nguyentrongtin1702/Robot-Scara-project-new/README.md

# Robot-Scara-project-new
this is the robot's project that i used to use when i were studing in university
in this project, this has all of things that you need to finish
And all of this file here, you should use it for referencing and developing your idea about robotic project
# IN THIS FILE
1. Solidwork robot
2. firmware robot
3. USER INTERFACE using python
4. ...
I hope that it is useful for you all
