nguyentrongtin1702/Robot-Scara-project-new/DO AN ROBOT - SCARA_bản cuối.pdf

i

BỘ GIÁO DỤC & ĐÀO TẠO

TRƯỜNG ĐẠI HỌC SƯ PHẠM KỸ THUẬT TP. HỒ CHÍ MINH

KHOA ĐIỆN – ĐIỆN TỬ

-----------------⸙∆⸙-----------------

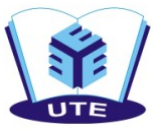
[picture p2: figure]

## ĐỒ ÁN KỸ THUẬT ROBOT

### THIẾT KẾ VÀ ĐIỀU KHIỂN MÔ HÌNH CÁNH TAY ROBOT

### SCARA 3 BẬC TỰ DO VỚI BỘ ĐIỀU KHIỂN PID

GVHD: Th.S Nguyễn Trần Minh Nguyệt

SVTH: Nguyễn Trọng Tín

MSSV: 21151174

SVTH: Nguyễn Tài Tuệ

MSSV: 21151490

Tp. Hồ Chí Minh tháng 06 năm 2025

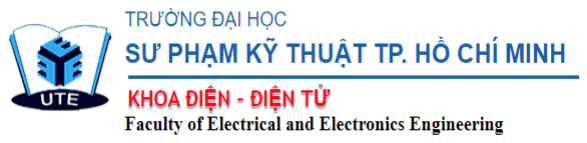
[picture p3: figure]

CỘNG HÒA XÃ HỘI CHỦ NGHĨA VIỆT NAM

Độc lập - Tự Do - Hạnh phúc ------------------
Tp. Hồ Chí Minh, tháng 06 năm 2025

PHIẾU NHẬN XÉT CỦA GIÁO VIÊN HƯỚNG DẪN

Họ và tên: Nguyễn Trọng Tín | MSSV: 21151174
Nguyễn Tài Tuệ | MSSV: 21151490

Ngành: Công nghệ Kỹ thuật Điều khiển và Tự động hóa

Tên đề tài: THIẾT KẾ VÀ ĐIỀU KHIỂN MÔ HÌNH CÁNH TAY ROBOT

SCARA 3 BẬC TỰ DO VỚI BỘ ĐIỀU KHIỂN PID

Giảng viên hướng dẫn: Th.s Nguyễn Trần Minh Nguyệt

NHẬN XÉT:

1. Về nội dung đề tài & khối lượng thực hiện:
2. Ưu điểm:
3. Khuyết điểm:
4. Điểm: | (Bằng chữ: | )
| Tp. Hồ Chí Minh, ngày…. tháng 06 năm 2025
| Giảng viên hướng dẫn
| (Ký & ghi rõ họ tên)

i

## LỜI CẢM ƠN

Chúng em chân thành cảm ơn, quý thầy cô trong khoa Điện – Điện tử trường

Đại học Sư Phạm Kỹ Thuật TP.HCM nói chung và quý thầy cô bộ môn Điều khiển

tự động nói riêng, đã trang bị kiến thức và giúp đỡ chúng em, giải quyết những khó

khăn trong suốt quá trình tìm hiểu và nghiên cứu đề tài.

Đặc biệt chúng em xin chân thành cảm ơn giảng viên hướng dẫn là Cô

Nguyễn Trần Minh Nguyệt đã tận tình hướng dẫn, truyền đạt kiến thức, kinh

nghiệm cho nhóm trong suốt quá trình vừa qua.

Xin chúc quý thầy cô nhiều sức khoẻ, thành công trong công việc, cuộc

sống và tiếp tục đào tạo các sinh viên giỏi góp phần đóng góp cho nhà trường,

đất nước.

Chúng em xin chân thành cảm ơn.

ii

## MỤC LỤC

CHƯƠNG 3: THIẾT KẾ MÔ HÌNH ROBOT TRÊN PHẦN MỀM

iii

CHƯƠNG 4: TÍNH TOÁN ĐỘNG HỌC, ĐỘNG LỰC HỌC, VẼ KHÔNG

GIAN LÀM VIỆC, QUY HOẠCH QUỸ ĐẠO VÀ XÂY DỰNG BỘ ĐIỀU

iv

### 6.5.2 Giao diện GUI điều khiển robot dựa trên thư viện Tkinter của Python:

v

## DANH SÁCH HÌNH ẢNH

Hình 4.5: Cấu trúc chương trình bộ điều khiển PID cho Robot SCARA trên MATLAB

Hình 4.8: Đáp ứng ngõ ra vị trí góc (độ) của 2 khâu robot tại setpoint 45 độ và 60 độ

vi

vii

## DANH SÁCH BẢNG

Bảng 4.7: Code của khối hàm MATLAB Function mô tả động lực học Robot Scara

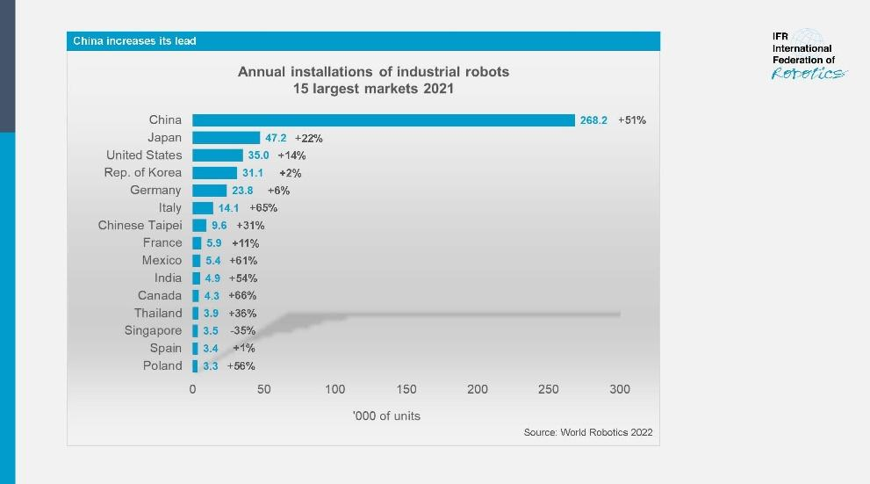
[picture p4: figure]

BỘ MÔN ĐIỀU KHIỂN TỰ ĐỘNG

CHƯƠNG 1

8

## CHƯƠNG 1: TỔNG QUAN VỀ ĐỀ TÀI

### 1.1 Đặt vấn đề:

Ngày nay, với những ưu điểm như sự năng suất, tính hiệu quả và khả thi,

cánh tay robot ngày càng khẳng định được tầm quan trọng của mình trong lĩnh vực

công nghiệp thông qua biểu đồ mô tả số lượng lắp đặt cánh tay máy như hình 1.1.

Hình 1.1: Thống kê số lượng robot được lắp đặt

Theo thống kê IFR (Hiệp hội Robot công nghiệp thế giới), năm 2022, Châu

Á là thị trường lớn nhất về robot công nghiệp được triển khai trên thế giới được lắp

đặt tại đây. Có thể thấy được việc sử dụng cánh tay máy trong công nghiệp đang dần

trở nên phổ biến và vô cùng quan trọng trong hệ thống tự động hóa công nghiệp.

Chẳng hạn như công nghệ thực phẩm, vật liệu xây dụng, luyện kim, chế tạo cơ khí

và một vài lĩnh vực khác. Trong chiến lực phát triển công nghiệp Việt Nam đến năm

2025, tầm nhìn 2035, chính phủ đã đặt ra mục tiêu giá trị sản phẩm công nghiệp cao

và sản phẩm ứng dụng công nghệ cao sau năm 2025 đạt trên 50%. Để làm được điều

này, Việt Nam cần tập trung phát huy nghiên cứu phát triển, làm chủ công nghệ về

robot – lĩnh vực trung tâm của cuộc cách mạng công nghệ lớn.

Bởi vì những lợi ích mà robot mang lại như sự mạnh mẽ, chính xác, tính ổn

định, liên tục… mà robot đã dần thay thế con người và khẳng định vị thế của mình

khi được sử dụng rộng rãi trong nhiều lĩnh vực trong công nghiệp đặc biệt là đối với

các ứng dụng đòi hỏi sự chính xác và tốc độ cao như lắp ráp các chi tiết cơ khí máy

gia công gỗ, vật liệu, đóng gói, hoặc hợp tác với con người để làm việc.

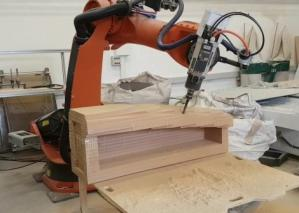
[picture p5: figure]
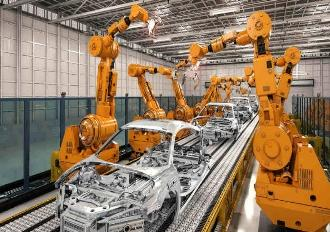
[picture p6: figure]

BỘ MÔN ĐIỀU KHIỂN TỰ ĐỘNG

CHƯƠNG 1

9

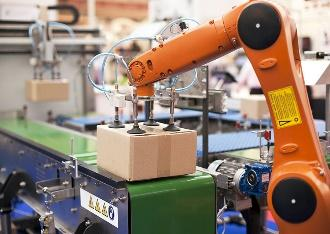
[picture p7: figure]

Hình 1.2: Các ứng dụng của robot

Tại Việt Nam: Nghiên cứu phát triển robot đã có những bước tiến đáng kể

trong 25 năm vừa qua. Nhiều đơn vị trên toàn quốc thực hiện các nghiên cứu cơ bản

và nghiên cứu ứng dụng về robot như Trung tâm Tự động hoá, Đại học Bách Khoa

Hà Nội, Viện Điện tử, Tin học, Tự động hoá thuộc Bộ Công nghệp, Đại học Bách

khoa TP.HCM, Viện Khoa học và Công nghệ quân sự, Học viện Kỹ thuật Quân sự,

Viện Cơ học, Viện Công nghệ thông tin thuộc Viện KHCNVN. Bên cạnh đó còn phải kể đến Công ty Cổ phần Robot TOSY, doanh nghiệp thiết kế và chế tạo robot Việt

Nam có nhiều sản phẩm ấn tượng trên trường quốc tế.

Trên thế giới: Các giải thuật điều khiển nâng cao được chú tâm nghiên cứu mạnh

mẽ như bộ điều khiển PID, điều khiển trượt, điều khiển mờ, điều khiển thích nghi...

đã được triển khai để giải quyết vấn đề robot khi có sự tồn tại của các thông số không

chắc chắn. Ngoài ra, các bộ điều khiển trở kháng, điều khiển kiểm soát lỗi, điều khiển

lực và điều khiển tối ưu đã được nghiên cứu phát triển và áp dụng vào cho cánh tay

máy để cải thiện độ tin cậy, tuổi thọ và độ an toàn khi các cánh tay máy hoạt động

cùng với nhau hay hoạt động song song cùng với con người. Từ những kết quả nghiên

cứu trên, ta có thể thấy các vấn đề liên quan tới robot đã và đang thu hút được rất

nhiều sự quan tâm của rất nhiều nhà nghiên cứu từ các trường đại học, viện nghiên

cứu và các công ty công nghệ ở trên thế giới.

Còn ở Việt Nam robot nói chung và robot công nghiệp thông minh nói riêng đang được sử dụng tại Việt Nam phần lớn là được nhập khẩu về từ các nước phát triển,

robot được chế tạo tại Việt Nam còn rất ít và hầu hết là đang sử dụng công nghệ cũ

của thế giới, chưa có đủ khả năng làm chủ công nghệ để thiết kế theo từng yêu cầu

cụ thể, cũng như chưa phát triển công nghệ phù hợp. Có rất ít công ty sản xuất và

phân phối sản phẩm robot ở trong nước. Nếu có thì hầu hết sản phẩm thuộc phân loại

BỘ MÔN ĐIỀU KHIỂN TỰ ĐỘNG

CHƯƠNG 1

10

robot công nghiệp truyền thống, hạn chế về tính thông minh, bậc tự do, kỹ năng động

lực học nâng cao.

### 1.2 Mục tiêu đề tài:

Mục tiêu của đề tài là thiết kế mô hình robot scara 3 bậc tự do, trong đó em muốn

đạt được các mục tiêu như sau:

❖ Trên mô phỏng:

- Tính toán động học thuận, nghịch, động lực học, quy hoạch quỹ đạo và vẽ

không gian làm việc robot trên MATLAB.
- Thiết kế mô hình robot sử dụng phần mềm SolidWorks.
- Thiết kế bộ điều khiển PID cho robot dựa trên các phương trình động lực học

robot.

❖ Trên thực nghiệm:
- Thiết kế mô hình thực robot.
- Kiểm chứng và chạy động học trên mô hình thực để gắp thả vật 5 điểm trên

bàn cờ.
- Xây dựng giao diện người dùng để quan sát và điều khiển robot.
- Thiết kế bộ điều khiển PID cho mô hình thực.

### 1.3 Giới hạn đề tài:

Trong khuôn khổ đề tài này, chỉ xem xét và nghiên cứu:

- Kiểm chứng động học thuận và động học nghịch trên mô hình thực.
- Kiểm chứng động lực học robot trên mô phỏng MATLAB
- Quy hoạch quỹ đạo cho robot trên mô phỏng MATLAB
- Chưa quan tâm đến động lực học robot trên mô hình thực.
- Chưa quy hoạch quỹ đạo trên mô hình thực.

### 1.4 Phương pháp nghiên cứu:

Đề tài sẽ áp dụng các phương pháp nghiên cứu sau:

Phân tích dữ liệu: Sử dụng công cụ MATLAB quan sát và thu thập dữ liệu từ các đồ thị đáp ứng và đưa ra một số đánh giá về kết quả của hệ thống dựa vào đồ thị

đáp ứng.

BỘ MÔN ĐIỀU KHIỂN TỰ ĐỘNG

CHƯƠNG 1

11

Phân tích mô phỏng: Dựa vào công cụ trên MATLAB Simulink để mô phỏng

động học, quy hoạch quỹ đạo, mô phỏng đáp ứng của bộ điều PID.

Phân tích thí nghiệm: Thực hiện trên mô hình thực nghiệm, dựa vào kết quả

thu được so sánh với kết quả trên mô hình mô phỏng và lý thuyết.

Tiêu chí đánh giá hệ thống: Đánh giá hệ thống qua kết quả trả về sai số bám

của robot so với tín hiệu đặt. So sánh chất lượng điều khiển dựa trên dữ liệu đã thu

thập trước đó.
Cải tiến thuật toán: Dựa trên kết quả đánh giá và phân tích, cải tiến cho thuật

toán điều khiển có thế là thay đổi các thông số bộ điều khiển.

Đánh giá kết quả: Đánh giá kết quả của các cải tiến thuật toán và so sánh với

hiệu suất của phiên bản ban đầu.

### 1.5 Nội dung đề tài:

Đề tài gồm có 7 chương:

Chương 1: Tổng quan về đề tài.

Chương 2: Cơ sở lý thuyết.

Chương 3: Thiết kế mô hình robot trên phần mềm SolidWorks.

Chương 4: Tính toán động học, động lực học, vẽ không gian làm việc, quy hoạch quỹ đạo và xây dựng bộ điều khiển cho robot.

Chương 5: Thi công mô hình thực tế.

Chương 6: Thiết kế chương trình điều khiển.

Chương 7: Kết luận và hướng phát triển.

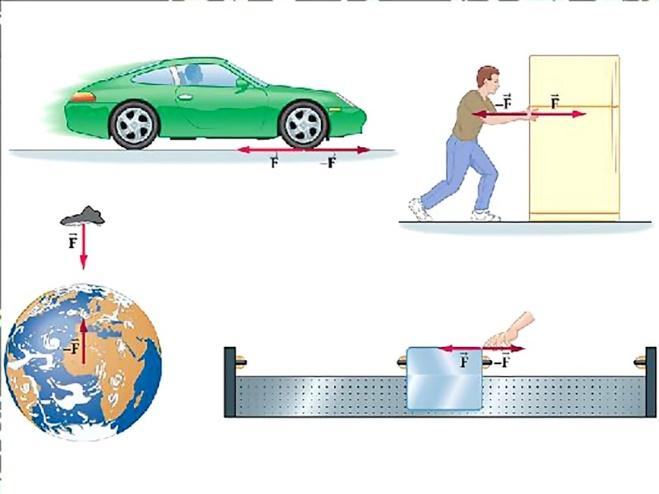
[picture p8: figure]

BỘ MÔN ĐIỀU KHIỂN TỰ ĐỘNG

CHƯƠNG 2

12

## CHƯƠNG 2: CƠ SỞ LÝ THUYẾT

### 2.1 Cơ sở lý thuyết về Lực, Torque và phương pháp cánh tay đòn:

Lực là bất kì ảnh hưởng nào làm cho một vật thể chịu sự thay đổi về hình dạng hay

làm ảnh hưởng đến chuyển động của nó. Nói cách khác lực là nguyên nhân làm cho

một vật có khối lượng thay đổi vận tốc hay làm biến dạng vật thể.

Một số ví dụ đơn giản về lực: Khi bạn đá quả bóng, bạn tác động một lực lên nó.

Khi bạn ngồi xuống, bạn chịu tác động của lực hấp dẫn trái đất. Mặt trăng chịu lực

hấp dẫn Trái Đất nên xoay quanh Trái Đất với một quỹ đạo nhất định, ... Tóm lại lực

nó có thể làm thay đổi hình dạng hoặc cấu trúc của một vật thể tùy vào độ lớn và

phương, chiều của lực.

Hình 2.1: Một số ví dụ đơn giản về lực

Trong khi lực tác động lên một vật sẽ tạo cho vật một chuyển động thẳng, tịnh tiến,

thì Torque được định nghĩa là khuynh hướng của lực làm xoay một vật quanh một trục cố định. Nói nôm na Torque cũng tương tự như lực nhưng sẽ tạo chuyển động

xoay cho vật.
Một ví dụ đơn giản: Ta muốn xoay một con ốc nhưng nếu sử dụng tay vặn thông

thường sẽ khó có thể mở con ốc ra, do đó ta sẽ dùng cờ lê để vặn ốc ra như ta tác

động một lực vào cờ lê và cờ lê có độ dài là d, d này được coi là cánh tay đòn, giúp cho việc vặn ốc trở nên dễ dàng hơn. Ta có công thức tính Torque xoay quanh trục

của con ốc là:

τ = Fd

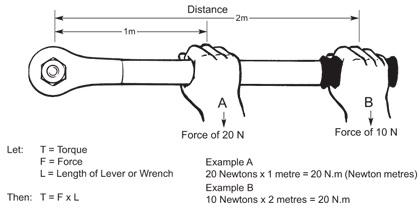
[picture p9: figure]

BỘ MÔN ĐIỀU KHIỂN TỰ ĐỘNG

CHƯƠNG 2

13

Theo như công thức độ lớn của τ sẽ tỉ lệ thuận với lực F tác động và độ dài cánh tay đòn d. Với một lực cố đinh, cánh tay đòn càng dài thì τ sẽ càng lớn.

Hình 2.2: Ví dụ về Torque

Trong trường hợp sử dụng động cơ RC Servo, lực tác động lên thanh robot chủ yếu là trọng lực và được tính bằng công thức:

F = mg

Trong đó: m là khối lượng của vật (kg) và g là hằng số gia tốc trọng trường g =

9.81m/s²

. Từ công thức, ta có mối quan hệ giữa Torque và cánh tay đòn là tỉ lệ thuận.

### 2.2 Động cơ DC có Encoder:

### 2.2.1 Khái niệm động cơ encoder:

Động cơ Encoder (motor encoder, tiếng Anh là Rotary Encoder) là tên của 1 loại

động cơ có phần con quay được tích hợp trong 1 hệ thống tự động nhằm mục đích

tạo tín hiệu xung trong hoạt động điều khiển động cơ hoặc các máy móc, thiết bị vận

hành trong quá trình sản xuất.

Mục đích chủ yếu của các dòng encoder chính là thực hiện mã hóa số vòng quay

nhằm mục đích tạo tín hiệu xung có dạng vuông ở trong quá trình điều khiển động

cơ.
Dựa trên sơ đồ tín hiệu có dạng nhị phân thì tất cả các dòng encoder đều có thể hỗ

trợ hoán đổi được các vị trí góc hoặc các vị trí thẳng căn cứ theo yêu cầu người sử

dụng có mong muốn dịch chuyển đến vị trí điều khiển như thế nào.

### 2.2.2 Các loại encoder:

❖ Encoder tuyệt đối:

- Encoder tuyệt đối (adsolute encoder): tức là tín hiệu ta nhận được từ Encoder

cho biết chính xác vị trí của Encoder mà không phải xử lý thêm gì cả.

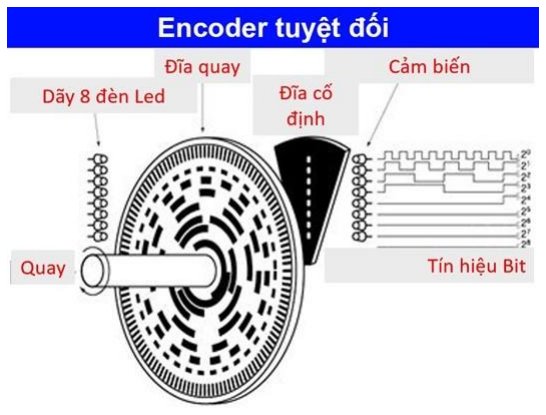
[picture p10: figure]
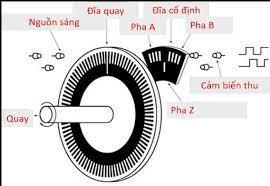
[picture p11: figure]

BỘ MÔN ĐIỀU KHIỂN TỰ ĐỘNG

CHƯƠNG 2

14

- Sử dụng đĩa theo mã nhị phân hoặc mã Gray.
- Có kết cấu gồm: bộ phát ánh sáng (LED), đĩa mã hóa (có chứa dãi băng mang

tín hiệu), một bộ thu ánh sáng nhạy với ánh sáng phát ra.
- Đĩa mã hóa ở Encoder được chế tạo từ vật liệu trong suốt, người ta đã chia mặt

đĩa thành các góc đều nhau cùng các đường tròn đồng tâm.

Hình 2.3: Encoder tuyệt đối

❖ Encoder tương đối:

- Encoder tương đối (incremental encoder): loại thiết bị này sẽ phát ra tín hiệu

tăng dần hoặc theo chu kỳ, có các đặc điểm như sau:

- Đĩa mã hóa bao gồm một dãy băng tạo xung, thường được chia thành nhiều lỗ

bằng nhau và được cách đều nhau.

- Chất liệu có thể là trong suốt để giúp ánh sáng chiếu qua.
- Là Encoder chỉ có 1,2 hoặc tối đa 3 vòng lỗ, và thường có thêm một lỗ định

vị.

Hình 2.4: Encoder tương đối

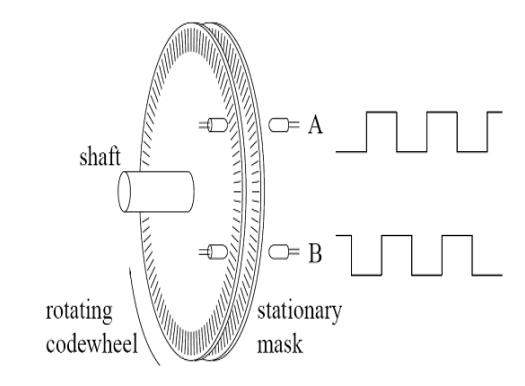
[picture p12: figure]

BỘ MÔN ĐIỀU KHIỂN TỰ ĐỘNG

CHƯƠNG 2

15

### 2.2.3 Nguyên lý làm việc của động cơ có encoder:

Encoder hoạt động tuân theo nguyên lý đó là khi ta cung cấp nguồn cho nó và khi

tất cả các trục quay đều hoạt động. Đồng thời, động cơ còn tạo cho đĩa tròn được

xoay vòng khi bạn đã xoay kéo theo chiếc đèn led sáng.

Ở trên đĩa tròn xoay còn có 1 cái lỗ và các lỗ này cũng được xen kẽ nhau. Dựa vào

đó, hệ thống xử lý vi sẽ đếm tất cả các lượt quay bằng cách đèn xuyên qua lỗ, hoặc

có thể không xuyên qua bằng 1 con bắt tích hợp ở trong đó truyền báo về.

Cũng chính vì vậy, các xung vuông của động cơ được tạo ra và bạn có thể đếm

được thông qua độ cắt của ánh sáng từ chiếc đèn led thông qua các lỗ hổng trên.

Hình 2.5: Encoder

### 2.3 Lý thuyết bộ điều khiển PID:

### 2.3.1 Khái niệm:

Bộ điều khiển vi tích phân tỉ lệ (bộ điều khiển PID) là một kỹ thuật điều khiển

quá trình với sự kết hợp của 3 bộ điều khiển: tỉ lệ, tích phân và vi phân, có khả năng

điều chỉnh sai số thấp nhất có thể, tăng tốc độ đáp ứng, giảm độ vọt lố, hạn chế dao

động.
Bộ điều khiển PID sẽ tính toán giá trị "sai số" là hiệu số giữa giá trị đo thông số

biến đổi và giá trị đặt mong muốn. Bộ điều khiển sẽ thực hiện giảm tối đa sai số bằng

cách điều chỉnh giá trị điều khiển đầu vào.

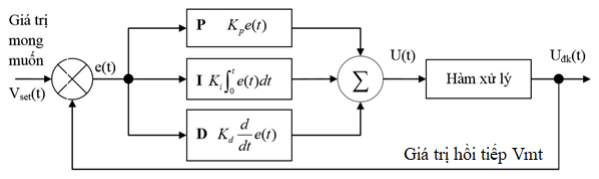
[picture p13: figure]
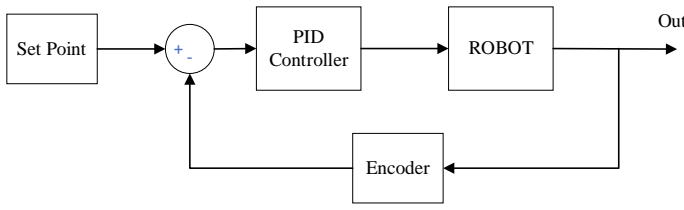
[picture p14: figure]
PID; Controller; ROBOT; Encoder; Set Point

BỘ MÔN ĐIỀU KHIỂN TỰ ĐỘNG

CHƯƠNG 2

16

Hình 2.6: Cấu trúc bộ điều khiển PID cho hệ vòng kín

Phương trình PID tổng quát:

U(t) = Kpe(t) + Ki ∫ e(t)dt + Kd

d
dt

t
0

e(t)

Trong đó:
− Vset là giá trị đặt (Setpoint) mong muốn.

− Vmt là giá trị Sensor phản hồi về vi điều khiển.

− e = Vset – Vmt là sai số giữa tín hiệu đặt và tín hiệu hồi tiếp.

− U là giá trị PID tính toán được.

− Uđk là giá trị điều khiển hệ thống

− Các giá trị Kp, Ki, Kd là các hằng số tỷ lệ, tích phân và vi phân

### 2.3.2 Thiết kế bộ điều khiển PID cho hệ thống:

Output

Hình 2.7: Cấu trúc bộ điều khiển PID cho hệ thống

Nguyên lý hoạt động: Tín hiệu đặt (Set point) là góc cần quay của robot. Thông

qua bộ điều khiển PID sẽ tính toán các thông số và đưa tín hiệu điều khiển vào robot.

Thông qua tín hiệu đọc về từ encoder, tín hiệu trả về là góc tại thời điểm t. Sai số giữa

tín hiệu đặt và tín hiệu trả về sẽ được tính toán và tiếp tục được đưa qua bộ điều khiển

để hiệu chỉnh tín hiệu điều khiển.

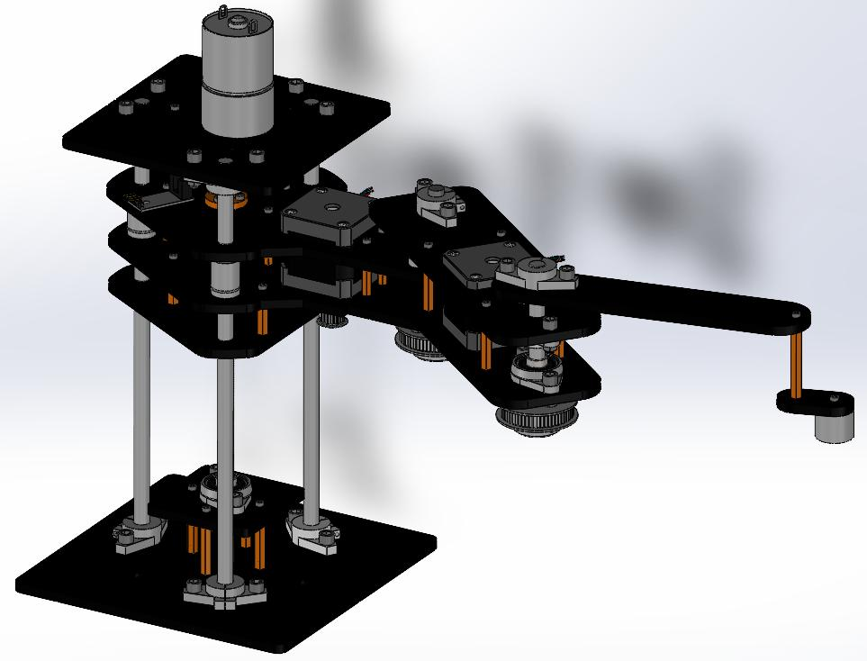
[picture p15: figure]

BỘ MÔN ĐIỀU KHIỂN TỰ ĐỘNG

CHƯƠNG 3

17

## CHƯƠNG 3: THIẾT KẾ MÔ HÌNH ROBOT TRÊN

## PHẦN MỀM SOLIDWORKS

### 3.1 Vẽ mô hình robot trên phần mềm SolidWorks:

Hình 3.1: Tổng quan mô hình Robot Scara đã thiết kế trên SolidWorks

Mô hình cánh tay Robot Scara 3 bậc tự do được hình thành từ 4 khâu chính bao gồm phần đế, khâu 1, khâu 2 và khâu 3. Để thiết kế được mô hình cánh tay Robot

Scara 3 bậc tự do như trên, đầu tiên ta sẽ tiến hành thiết kế lần lượt từng khối riêng

biệt. Sau đó tiến hành lắp ghép các khối lại với nhau ta thu được một mô hình cánh

tay Robot Scara 3 bậc tự do hoàn chỉnh. Các bước thiết kế sẽ được trình bày trong

các phần tiếp theo.

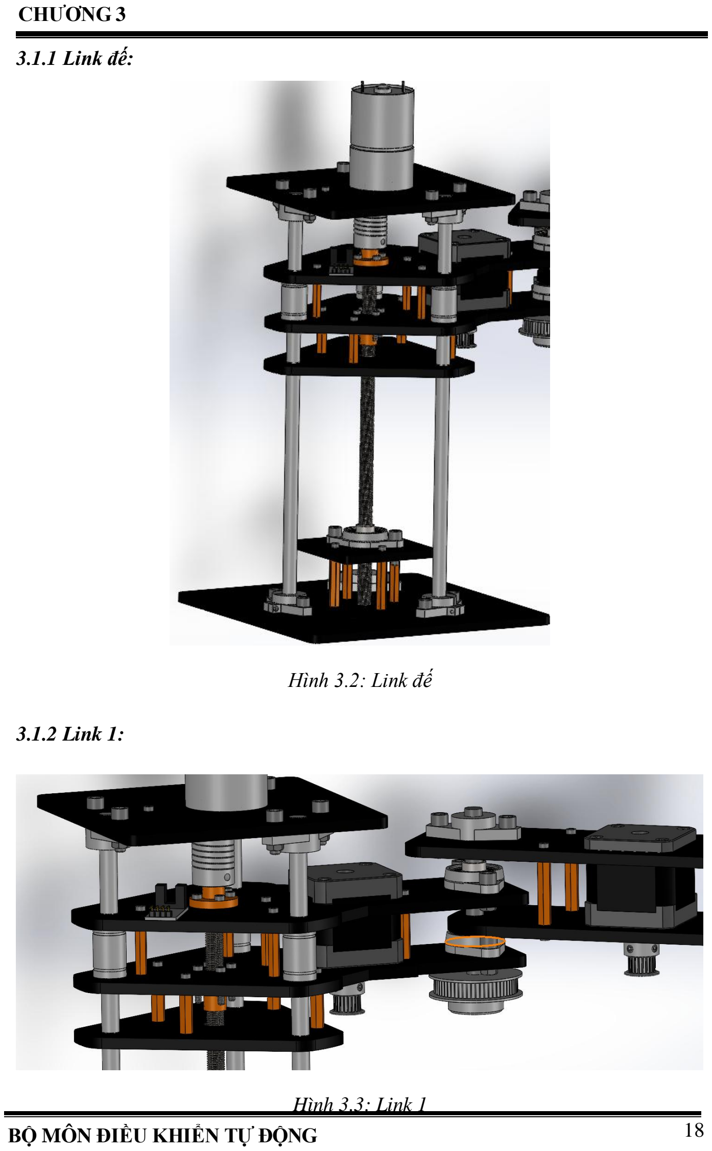
[picture p16: page 20]

BỘ MÔN ĐIỀU KHIỂN TỰ ĐỘNG

CHƯƠNG 3

18

### 3.1.1 Link đế:

Hình 3.2: Link đế

### 3.1.2 Link 1:

Hình 3.3: Link 1

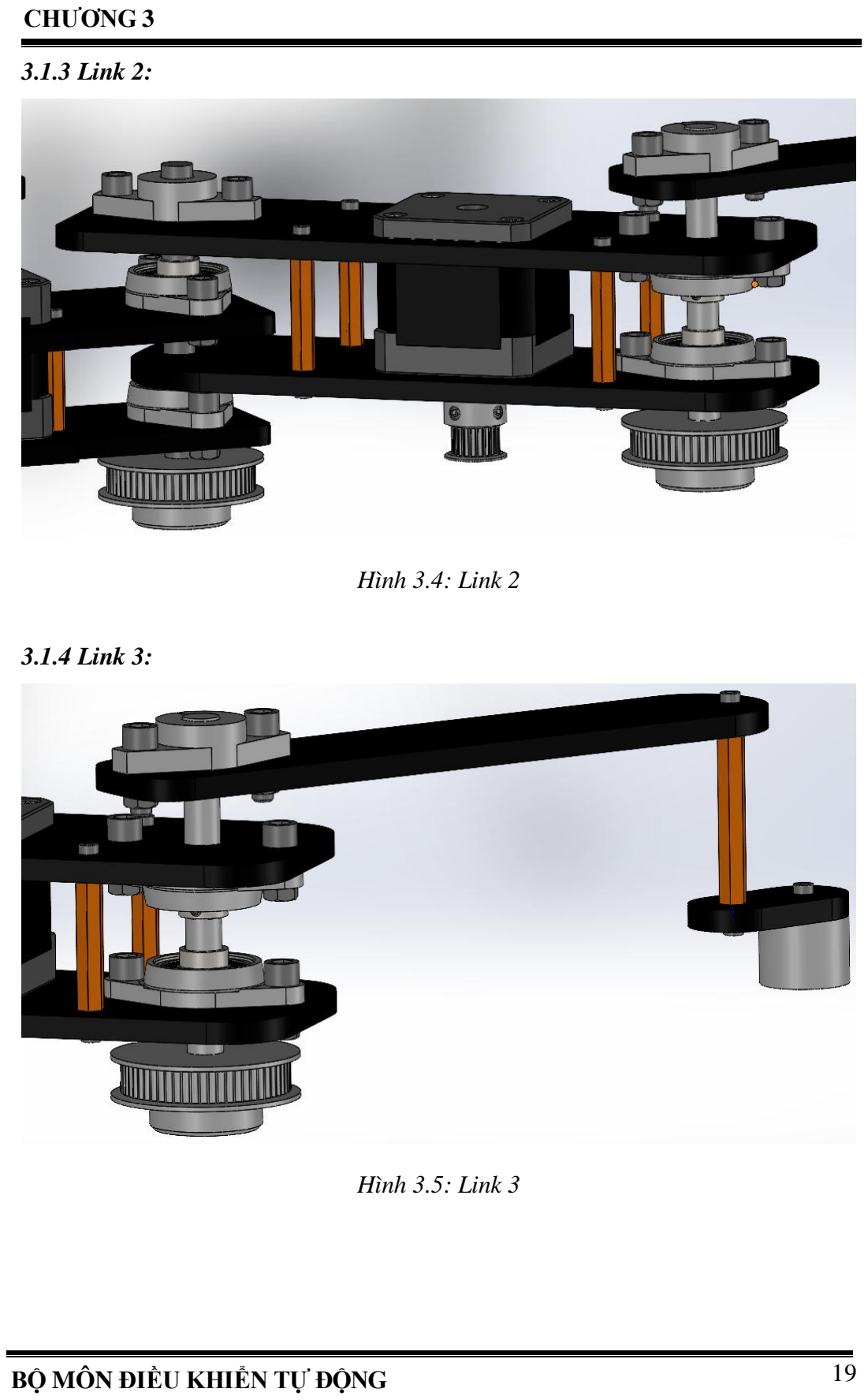
[picture p17: page 21]

BỘ MÔN ĐIỀU KHIỂN TỰ ĐỘNG

CHƯƠNG 3

19

### 3.1.3 Link 2:

Hình 3.4: Link 2

### 3.1.4 Link 3:

Hình 3.5: Link 3

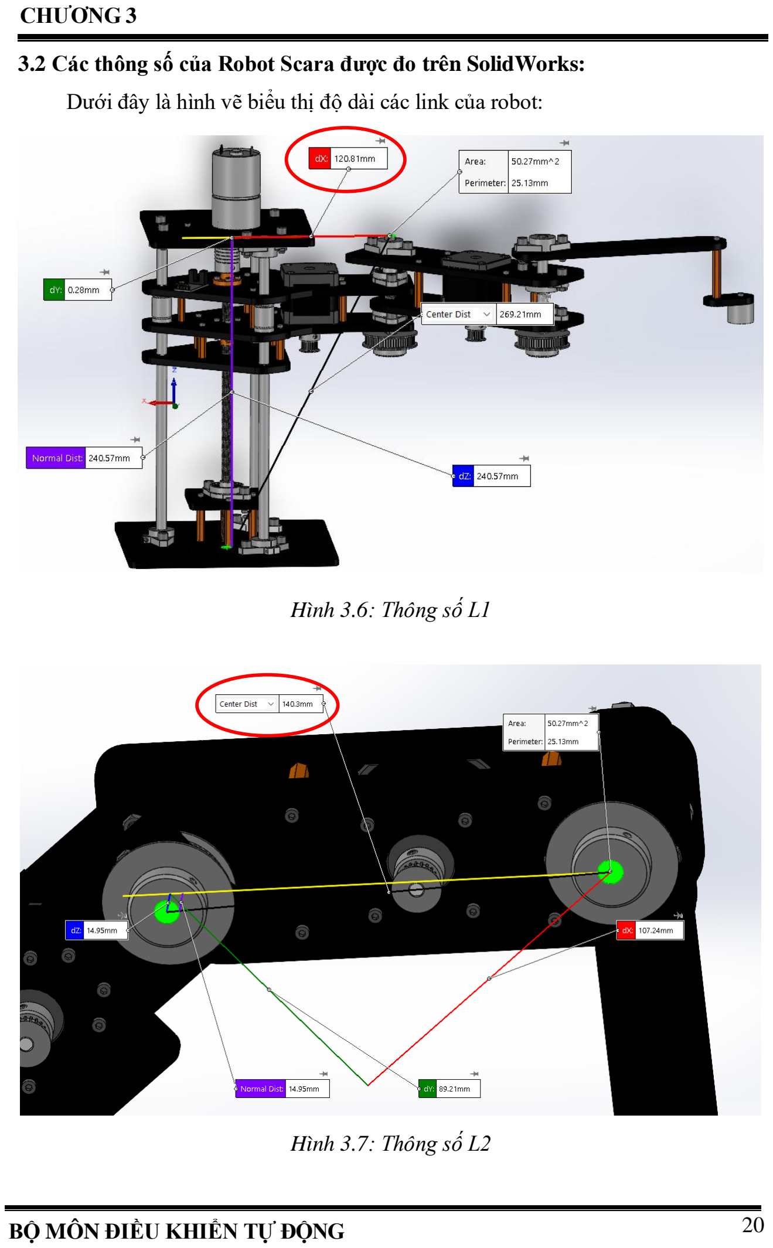
[picture p18: page 22]

BỘ MÔN ĐIỀU KHIỂN TỰ ĐỘNG

CHƯƠNG 3

20

### 3.2 Các thông số của Robot Scara được đo trên SolidWorks:

Dưới đây là hình vẽ biểu thị độ dài các link của robot:

Hình 3.6: Thông số L1

Hình 3.7: Thông số L2

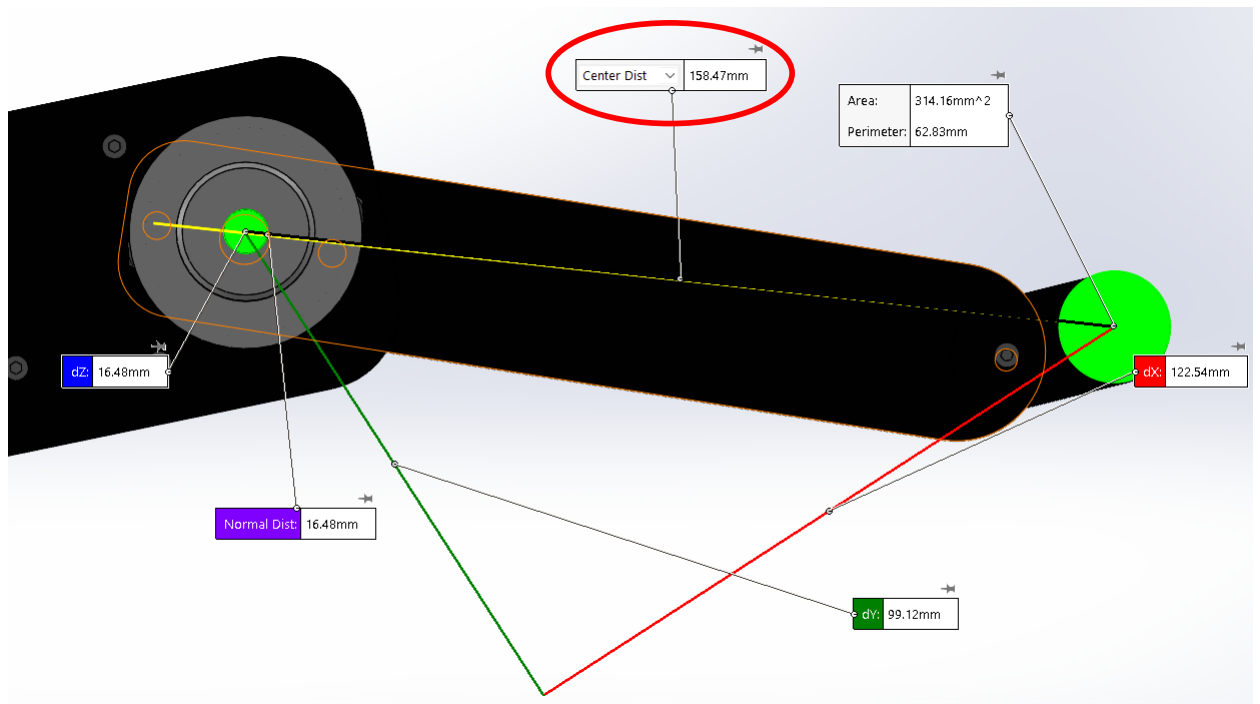
[picture p19: figure]

BỘ MÔN ĐIỀU KHIỂN TỰ ĐỘNG

CHƯƠNG 3

21

Hình 3.8: Thông số L3

Qua đó, ta có bảng thông số Robot Scara như sau:

Thông số | Kích thước (mm)
L1 | 120.81
L2 | 140.3
L3 | 158.47
Bảng 3.1: Các thông số robot

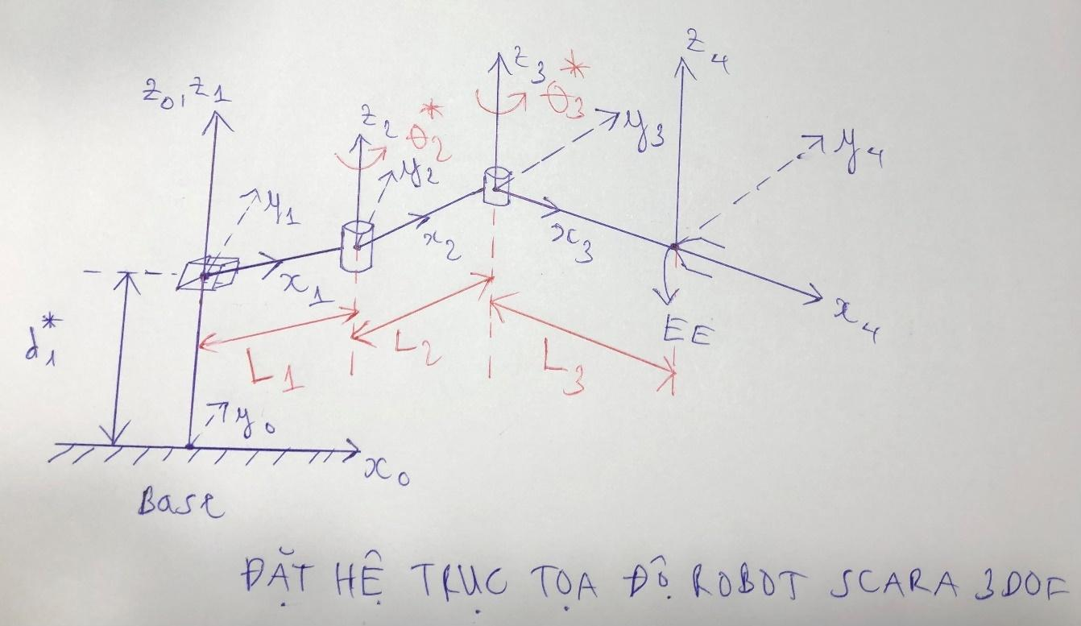
[picture p20: figure]

BỘ MÔN ĐIỀU KHIỂN TỰ ĐỘNG

CHƯƠNG 4

22

## CHƯƠNG 4: TÍNH TOÁN ĐỘNG HỌC, ĐỘNG LỰC

## HỌC, VẼ KHÔNG GIAN LÀM VIỆC, QUY HOẠCH

## QUỸ ĐẠO VÀ XÂY DỰNG BỘ ĐIỀU KHIỂN CHO

## ROBOT SCARA

### 4.1 Đặt hệ trục tọa độ Robot Scara:

Hình 4.1: Đặt hệ trục tọa độ cho robot scara 3 bậc tự do
Cấu trúc Robot Scara 3 bậc tự do gồm phần đế, 1 khớp tịnh tiến và 2 khớp

xoay tương ứng với cấu hình như sau:

- Khớp tịnh tiến được đặt vuông góc với mặt đất
- Khớp xoay thứ 2 và thứ 3 song song nhau và song song với khớp tịnh tiến.
- d1

là khoảng cách từ X0 đến X1 đo dọc theo trục Z1

. Vì là khớp tịnh tiến

nên d1 có thể thay đổi được.

- L1

là khoảng cách từ Z1 đến Z2 đo dọc theo trục X1

- L2

là khoảng cách từ Z2 đến Z3 đo dọc theo trục X2

- L3

là khoảng cách từ Z3 đến Z4 đo dọc theo trục X3

- Các khớp xoay lần lượt là θ2

,θ3 và khớp tịnh tiến là d1

BỘ MÔN ĐIỀU KHIỂN TỰ ĐỘNG

CHƯƠNG 4

23

Hệ trục tọa độ cánh tay robot được đặt như sau:
Hệ tọa độ gốc {0} được đặt ở mặt phẳng đế, trục Z0 được chọn dọc theo hướng

tịnh tiến của khớp thứ 1, trục X0 nằm song song với mặt phẳng đế, trục Y0 được xác

định theo quy tắc bàn tay phải.

Hệ tọa độ {1} được đặt trục X1Y1Z1 cùng phương và hướng với X0Y0Z0 nhưng

tâm của hệ tọa độ {1} được tịnh tiến lên xuống (không cố định) với một đoạn là d1 .

Hệ tọa độ {2} được đặt tại tâm xoay khớp thứ 2, trục Z2 được đặt dọc theo trục

khớp thứ 2, trục X2 nằm dọc theo khâu 2 (dọc theo đường vuông góc chung giữa Z2và

Z3

), trục Y2 được xác định theo nguyên tắc bàn tay phải.

Hệ tọa độ {3} được đặt tại khớp xoay thứ 3, trục Z3 được đặt dọc theo trục

khớp thứ 3, trục X3 nằm dọc theo khâu 3 (dọc theo đường vuông góc chung giữa Z3và

Z4
).
Hệ tọa độ cơ cấu chấp hành cuối {4} được đặt tại điểm cuối robot để có thể dễ

dàng xác định hướng và vị trí của cánh tay máy, các trục X4Y4Z4được đặt cùng

phương và hướng với X3Y3Z3

### 4.2 Lập bảng DH và tính toán động học thuận:

Bước 1: Lập bảng D-H

Từ hình 4.1 ta lập được bảng DH như sau:

i | a − i 1 | αi−1 | d i | θi
1 | 0 | 0 | d 1 | 0
2 | L1 | 0 | 0 | θ2
3 | L2 | 0 | 0 | θ3
4 | L3 | 0 | 0 | 0

Bảng 4.1: Bảng DH
Bước 2: Tìm ma trận chuyển đổi đồng nhất giữa các hệ trục tọa độ

iT

i−1 =
[
cos( θi) | −sin( θi) | 0 | ai−1
sin( θi) cos( αi−1) cos( θi) cos( αi−1) − sin( αi−1) − sin( αi−1)di
sin( θi) sin( αi−1) cos( θi) sin( αi−1) | cos( αi−1) | cos( αi−1)di
0 | 0 | 0 | 1

]

BỘ MÔN ĐIỀU KHIỂN TỰ ĐỘNG

CHƯƠNG 4

24

Ma trận chuyển đổi từ hệ trục tọa độ {1} sang hệ trục tọa độ gốc {0}:

1T

0 | = [
1 0 0 | 0
0 1 0 | 0
0 0 1 d1
0 0 0 1

]

Ma trận chuyển đổi từ hệ trục tọa độ thứ {2} sang hệ trục tọa độ thứ {1}:

2T

1 = [

cos( θ2) − sin( θ2) 0 L1
sin( θ2) | cos( θ2) | 0 0
0 | 0 | 1 0
0 | 0 | 0 1

]

Ma trận chuyển đổi từ hệ trục tọa độ thứ {3} sang hệ trục tọa độ thứ {2}:

3T

2 = [

cos( θ3) − sin( θ3) 0 L2
sin( θ3) | cos( θ3) | 0 | 0
0 | 0 | 1 | 0
0 | 0 | 0 | 1

]

Ma trận chuyển đổi từ hệ trục tọa độ cơ cấu chấp hành cuối {4} sang hệ trục

tọa độ thứ {3}:

4T

3 = [

1 0 0 L3
0 1 0 0
0 0 1 0
0 0 0 1

]

Bước 3: Tìm ma trận chuyển đổi đồng nhất giữa hệ trục tọa độ cơ cấu chấp

hành cuối {4} và hệ trục tọa độ gốc {0}

4T

0 | = 1T
| 0
2T

1
3T

2
4T

3 = [
4R

0
4P

0
0 0 0 1

]

Bước 4: Xác định ma trận hướng và ma trận vị trí từ ma trận chuyển đổi đồng

nhất tìm được từ Bước 3.

Ma trận hướng:

4R

0 | = [
r11 | r12 | r13
r21 | r22 | r23
r31 | r32 | r33

] = [

c23 | −s23 | 0
s23 | c23 | 0
0 | 0 | 1

]

Trong đó si

, ci

, s23 và c23 lần lượt thể hiện cho sin( θi), cos( θi), sin( θ2 +

θ3) và cos( θ2 + θ3), tương ứng với (i = 1,2,3)

BỘ MÔN ĐIỀU KHIỂN TỰ ĐỘNG

CHƯƠNG 4

25

Ma trận vị trí:

4P

0 = [

px
py
pz

]

Trong đó

px = L1 + L3c23 + L2c2

py = L3s23 + L2s2

pz = d1

### 4.3 Tính toán động học nghịch:

Định nghĩa 1: Đặt hàm tính toán lượng giác basis_02, để giải phương trình lượng

giác dạng:
{

a cos( x) − b sin( x) = c
b cos( x) + a sin( x) = d

Từ pt bên trên, ta giải hệ phương trình bậc nhất hai ẩn là cos(x) và sin(x) ta được:

{

sin( x) =

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
cos( x) =

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
Suy ra phương trình chỉ có một nghiệm.

x = atan 2 (sin(x) , cos(x))

Hay

x = atan 2 (ad − bc, ac + bd)

Điều kiện phương trình thỏa mãn
{
2a

2 + 2b

2 − (c

2 + d

2
) ≥ 0
a ≠ 0
- Giải θ3
: Từ ma trận vị trí ta có:
{

px − L1 = L3c23 + L2c2
py = L3s23 + L2s2

BỘ MÔN ĐIỀU KHIỂN TỰ ĐỘNG

CHƯƠNG 4

26

Ta lấy tổng bình phương hai vế của phương trình, suy ra:

(px − L1

)

2 + (py)

2
= (L3c23 + L2c2

)

2 + (L3s23 + L2s2
)

2

Triển khai vế phải của phương trình, rút gọn lại ta được:

(px − L1

)

2 + (py)

2
= L3

2 + L2

2 + 2L2L3c3

Chuyển vế phương trình để rút ra
3

c

c3 =

(px−L1

)

2+(py)

2
−L3

2−L2

2

2L2L3
Đặt {

nx = px − L1
ny = py

Phương trình trở thành

c3 =

nx

2+ny

2−L3

2−L2

2

2L2L3

Suy ra
s3 = ±√1 − (c3
)

2

Ta tìm được nghiệm:
θ3 = atan2(s3

, c3)

- Giải θ2
:
Từ kết quả phương trình bên trên ta suy ra được:
{

nx = L3c23 + L2c2 = c2(L3c3 + L2) − s2(L3s3) ny = L3s23 + L2s2 = s2(L3c3 + L2) + c2(L3s3)

Dùng hàm lượng giác dạng basic_02, ta tìm được nghiệm: θ2 = atan2(A, B)

Với
{
A = ny

(L3c3 + L2

) − nxL3s3
B = nx

(L3c3 + L2

) + nyL3s3

### 4.4 Kiểm chứng động học thuận – nghịch robot:

Để kiểm chứng động học thuận trên Matlab Simulink, ta sử dụng 1 khối

Constant với kích thước ma trận [3x1] để nhập 1 giá trị khoảng cách và 2 giá trị góc

tương ứng cho d1

,θ2

, θ3 của các khớp và 1 khối Display để hiển thị 3 vị trí Px, Py,

BỘ MÔN ĐIỀU KHIỂN TỰ ĐỘNG

CHƯƠNG 4

27

Pz của cơ cấu chấp hành. Chương trình trong khối MATLAB Function ở Bảng 4.2 là

kết quả tính toán động học thuận mà ta đã tìm được ở trên.

function Position = ForwardKinematics(Dis_Ang)
d1 = Dis_Ang(1);
theta2 = Dis_Ang(2);
theta3 = Dis_Ang(3);
%% Thông số robot SCARA
L1 = 120.81; L2 = 140.3; L3 = 158.47;
%% Forward Kinematics
Px = L1 + L3*cosd(theta2 + theta3) + L2*cosd(theta2); Py = L3*sind(theta2 + theta3) + L2*sind(theta2);
Pz = d1;
Position = [Px; Py; Pz];
end
Bảng 4.2: Chương trình MATLAB kiểm chứng động học thuận

Để kiểm chứng động học nghịch trên Matlab Simulink, ta sử dụng 1 khối

Constant với kích thước ma trận [3x1] để nhập 3 giá trị vị trí Px, Py, Pz của cơ cấu

chấp hành và 1 khối Display để hiển thị khoảng cách d1 và 2 góc tương ứng cho θ2 ,θ3

của các khớp. Chương trình trong khối MATLAB Function ở Bảng 4.3 là kết quả tính

toán động học nghịch mà ta đã tìm được ở trên.

function Dis_Ang = InverseKinematics(Position,button)
Px = Position(1);
Py = Position(2);
Pz = Position(3);
%% Thông số robot SCARA
L1 = 120.81; L2 = 140.3; L3 = 158.47; %% Inverse Kinematics
% theta3
nx = Px - L1;
ny = Py;
c3 = (nx^2 + ny^2 - L3^2 - L2^2)/(2*L2*L3); if button == 0
s3 = sqrt(1 - (c3^2));
else
s3 = -sqrt(1 - (c3^2));
end
theta3 = atan2d(s3,c3);
% theta2
A = ny*(L3*cosd(theta3) + L2)- nx*L3*sind(theta3); B = nx*(L3*cosd(theta3) + L2)+ ny*L3*sind(theta3); theta2 = atan2d(A,B);
Dis_Ang = [Pz; theta2; theta3];

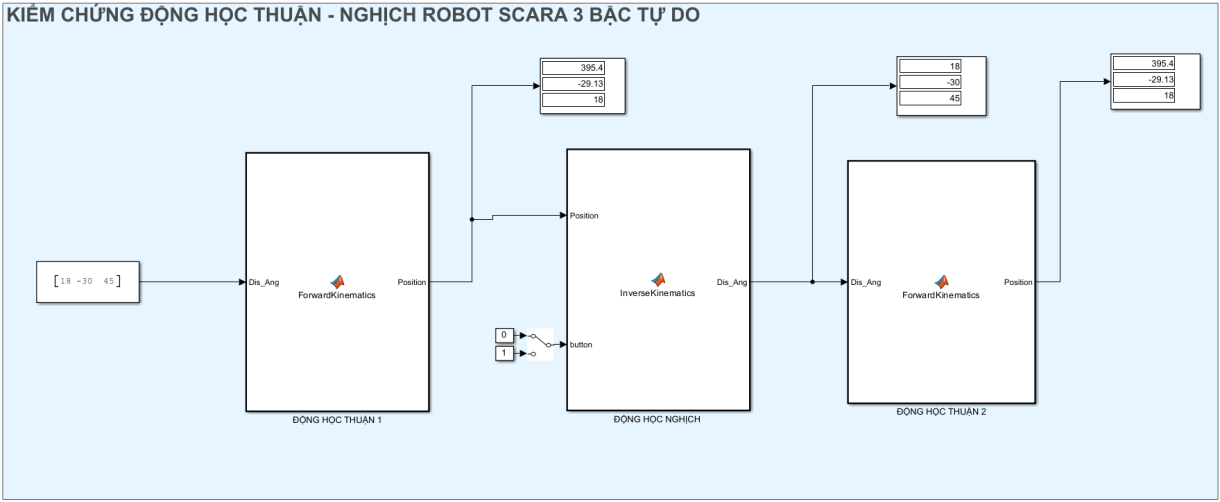
[picture p21: figure]

BỘ MÔN ĐIỀU KHIỂN TỰ ĐỘNG

CHƯƠNG 4

28

end
Bảng 4.3: Chương trình Matlab kiểm chứng động học nghịch

Hình 4.2: Kiểm chứng động học thuận – nghịch trên MATLAB Simulink

### 4.5 Vẽ không gian làm việc của robot:

Với các giới hạn góc d1 ∈ [0; 250]; θ2 ∈ [−

π
2

;

π
2

]; θ3 ∈ [−

π
2

;

π
2

], độ dài các

thanh liên kết là L1 = 120.81, L2 = 140.3, L3 = 158.47, chúng ta sử dụng phần mềm

MATLAB để vẽ được không gian làm việc của Robot.

clc;
close all;
clear all;
%% Thông số robot SCARA
L1 = 120.81; L2 = 140.3; L3 = 158.47; %% Chương trình
m = [];
for d1 = 0:8:250
for the2 = -90:8:90
for the3 = -90:8:90
x = L1 + L3*cosd(the2 + the3) + L2*cosd(the2); y = L3*sind(the2 + the3) + L2*sind(the2);
z = d1;
m(:, end + 1) = [x; y; z];
%m(1:3, end + 1) = [x; y; z];
end
end
end
%% Hiển thị
figure;
grid on;
plot3(m(1,:), m(2,:), m(3,:),'*b', 'MarkerSize', 3);

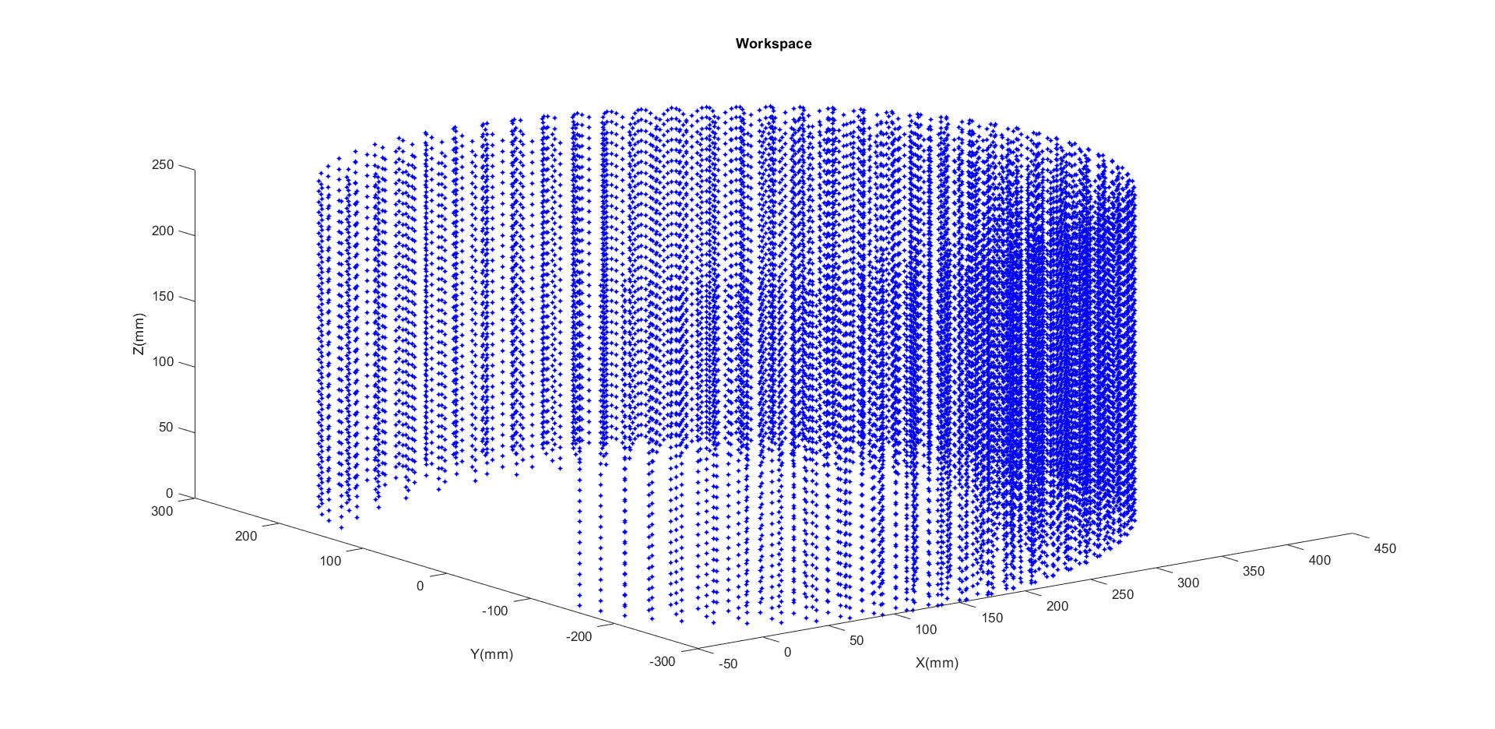
[picture p22: figure]

BỘ MÔN ĐIỀU KHIỂN TỰ ĐỘNG

CHƯƠNG 4

29

title("Workspace");
xlabel("X(mm)");
ylabel("Y(mm)");
zlabel("Z(mm)");

Bảng 4.4: Chương trình MATLAB vẽ không gian làm việc của Robot

Hình 4.3: Không gian làm việc Robot Scara

### 4.6 Tính toán quy hoạch quỹ đạo cho Robot:

Chọn đa thức bậc 3 (Cubic) để quy hoạch quỹ đạo robot.

Yêu cầu 4 điều kiện biên: vị trí và vận tốc.

Bởi vì các biên dạng gia tốc liên tục không giống như các quỹ đạo vận tốc hình

thang nên các quỹ đạo đa thức rất hữu ích để nối các đoạn lại với nhau với vận tốc và

gia tốc bằng không hoặc khác không.

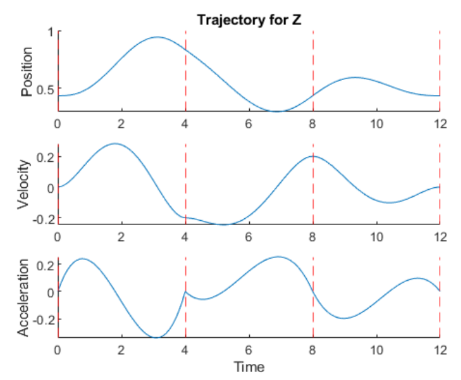
[picture p23: figure]

BỘ MÔN ĐIỀU KHIỂN TỰ ĐỘNG

CHƯƠNG 4

30

Hình 4.4: Quy hoạch quỹ đạo kiểu đa thức

❖ Các điều kiện ràng buộc:

Tại điểm bắt đầu:

t = t0

, q(t0

) = q0
,

d
dt

q(t0) = v0

Tại điểm đích:

t = tf, q(tf) = qf,

d
dt

q(tf) = vf

Phương trình đa thức bậc 3:

q(t) = a0 + a1
t + a2

t

2 + a3
t

3
,

d
dt

q(t) = a1 + 2a2
t + 3a3

t

2

Từ các điều kiện ràng buộc ta có:

q0 = a0 + a1

t0 + a2

t0

2 + a3
t0

3

v0 = a1 + 2a2

t0 + 3a3

t0

2

qf = a0 + a1

tf + a2

tf

2 + a3
tf

3

vf = a1 + 2a2

tf + 3a3

tf

2

Các tham số của đa thức bậc 3 có thể được tính như sau:

{

a0 = q0
a1 = v0

a2 =

3
tf

2

(qf − q0) −

2
tf

v0 −

1
tf

vf

a3 = −

2
tf

3

(qf − q0) +

1
tf

2

(vf + v0)

BỘ MÔN ĐIỀU KHIỂN TỰ ĐỘNG

CHƯƠNG 4

31

### 4.7 Tính toán động lực học Robot:

### 4.7.1 Các thông số vật lý của robot:

Kí hiệu | Mô tả | Thông số
m1 | Khối lượng khớp thứ nhất | 2 kg
m2 | Khối lượng khớp thứ hai | 1.5 kg
m3 | Khối lượng khớp thứ ba | 1 kg
L1 | Chiều dài khớp thứ nhất | 0.12081 m
L2 | Chiều dài khớp thứ hai | 0.1403 m
L3 | Chiều dài khớp thứ ba | 0.15847 m
I2 | Moment quán tính khớp thứ hai | 0.01 kg.m²
I3 | Moment quán tính khớp thứ ba | 0.01 kg.m²
g | Gia tốc trọng trường | -9.81 m/s²
θ2 | Góc quay khớp thứ hai | radian
θ3 | Góc quay khớp thứ ba | radian
b | Hệ số ma sát trượt | 0.1
c | Hệ số ma sát nhớt | 10⁻⁴

Bảng 4.5: Các thông số vật lí của hệ cánh tay Robot Scara

### 4.7.2 Các phương trình mô tả hệ thống:

Giả sử trọng tâm nằm ở vị trí giữa khâu, các thông số moment quán tính, hệ số

ma sát trượt và ma sát nhớt được đề cập ở bảng 4.5. Bỏ qua ngoại lực tác động.

Các biến khớp là θ = [θ2 θ3] T

Vì đế robot được đặt cố định nên:

0ω

0 = [0 0 0]

T
, 0v

0 = [0 0 0]

T

Gia tốc trọng trường ngược với chiều trục Z0 của hệ tọa độ gốc nên:

g

0 = [

0
0
−9.81

]

BỘ MÔN ĐIỀU KHIỂN TỰ ĐỘNG

CHƯƠNG 4

32

Từ các tính toán động học thuận phía trên ta có những ma trận sau:

1R

0 = [

1 0 0
0 1 0
0 0 1

], 1P

0 = [

0
0
d1

], 0R

1 = [

1 0 0
0 1 0
0 0 1

],

c P1

1 = [

L1
2

0 0]

T
, 1P

0 = [0 0 d1
]

T

2R

1 | = [
cθ2 | −sθ2 | 0
sθ2 | cθ2 | 0
0 | 0 | 1

], 2P

1 = [

L1
0
0

], 1R

2 | = [
cθ2 | sθ2 | 0
−sθ2 | cθ2 | 0
0 | 0 | 1

],

c P2

2 = [

L2
2

0 0]

T
, 2P
1 | = [L1 | 0 0]

T

3R

2 | = [
cθ3 | −sθ3 | 0
sθ3 | cθ3 | 0
0 | 0 | 1

], 3P

2 = [

L2
0
0

], 2R

3 | = [
cθ3 | sθ3 | 0
−sθ3 | cθ3 | 0
0 | 0 | 1

],

c P3

3 = [

L3
2

0 0]

T
, 3P
2 | = [L2 | 0 0] T

Xác định vận tốc tuyến tính và vận tốc quay của từng trục:

Tại khâu 1:
- Vị trí trọng tâm của khâu 1 so với trục gốc:
| | c P1
0 | = 1T

0
. c P1

1

- Vì là chuyển động tịnh tiến nên vận tốc góc tại hệ trục tọa độ 1 bằng 0:
| | 1ω
1 | = [

0
0/0]
- Vận tốc dài tại hệ trục tọa độ 1:

1v

1 = 0R

1
( 0v

0 + 0ω

0
. 1P

0
)
- Vận tốc dài tại trọng tâm khâu 1 so với trục gốc:

c v1

0 = 1R

0
( 1v

1 + 1ω

1
. c P1

1
) = 1R

0
∗ 1v

1

Tại khâu 2:
- Vị trí trọng tâm của khâu 2 so với trục gốc:

BỘ MÔN ĐIỀU KHIỂN TỰ ĐỘNG

CHƯƠNG 4

33

c P2

0 | = 2T
| 0
. c P2

2

- Vận tốc góc tại hệ trục tọa độ 2:

2ω

2 | = 1R
| 2
1ω

1 + θ̇
2 Ẑ
2

2

- Vận tốc dài tại hệ trục tọa độ 2:

2v

2 = 1R

2
( 1v

1 + 1ω

1
. 2P

1
)
- Vận tốc dài tại trọng tâm khâu 1 so với trục gốc:

c v2

0 = 2R

0
( 2v

2 + 2ω

2
. c P2

2
)

Tại khâu 3:
- Vị trí trọng tâm của khâu 3 so với trục gốc:

c P3

0 = 3T

0
. c P3

3

- Vận tốc góc tại hệ trục tọa độ 3:

3ω

3 | = 2R
| 3
2ω

2 + θ̇
3 Ẑ
3

3

- Vận tốc dài tại hệ trục tọa độ 3:

3v

3 | = 2R
| 3
( 2v

2 + 2ω

2
. 3P

2
)
- Vận tốc dài tại trọng tâm khâu 3 so với trục gốc:

c v3

0 | = 3R
| 0
( 3v

3 + 3ω

3
. c P3

3
)

Áp dụng công thức Lagrange:

L(θ, θ̇) = K(θ, θ̇) − U(θ)

Năng lượng động năng:

K(θ, θ̇) =

1
2

(m1
. c v1
T | . c v1
| 0
) +

1
2

(m2
. c v2

T
. c v2

0 + 2ω

T
. I2

c2
. 2ω

2
)

+

1
2

(m3
. c v3

T
. c v3

0 + 3ω

| T . I3 c3
. 3ω

3
)

Năng lượng thế năng:

U(θ) = −m1
. g

0 T
. c P1

0 − m2
. g

0 T
. c P2

0 − m3
. g

0 T
. c P3

0

(Với Uref1, Uref2, Uref3 là thế năng tại hệ trục gốc, ta sẽ cho bằng 0)

Theo phương trình Lagrange, moment xoắn của cánh tay robot được mô tả bởi phương

trình vi phân sau:

BỘ MÔN ĐIỀU KHIỂN TỰ ĐỘNG

CHƯƠNG 4

34

τi =

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
,i = 2,3

Với τi là moment xoắn tại khớp i.

Moment xoắn tại khớp 1 bằng 0 vì moment xoắn không xuất hiện trong khớp tịnh

tiến:

τ1 = 0

Moment xoắn tại khớp 2:

τ2 =

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
= f2(θ, θ̇

, θ̈)

Moment xoắn tại khớp 3:

τ3 =

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
= f3(θ, θ̇

, θ̈)

Phương trình động lực của cánh tay robot được trình bảy như sau:
M(θ)θ̈+ C(θ, θ̇)θ̇ + G(θ) + τf + J TFe = τ

Trong đó: M(θ): là ma trận quán tính, C(θ, θ̇): là ma trận Coriolis, G(θ): là ma trận

trọng trường,
τf = c. sign(θ̇) + bθ̇ lần lượt là moment ma sát nhớt và moment ma sát trượt (N.m),

J là ma trận Jacobia, và Fe

là ngoại lực tác động lên Robot tại khâu cuối.

Với θ = [θ2 θ3]

T

, θ̇ = [θ̇
2 θ̇
3

]

T

, θ̈= [θ̈
2 θ̈
3

]

T

Và ma trận M, C, G được tính bằng các công thức sau:

M =

∂τ
∂θ̈

; C =

dM
dt −

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
∂θn]

; G =

∂U
∂θ

%% Động lực học Robot 3 SCARA clc
clear all
%% Khai báo biến và kiểu dữ liệu
syms L1 L2 L3 d1 e2 e3 de2 de3 dde2 dde3 m1 m2 m3 I2 I3 g assume(L1,'real'); assume(L2,'real'); assume(L3,'real'); assume(d1,'real');
assume(e2,'real'); assume(e3,'real'); assume(de2,'real');

BỘ MÔN ĐIỀU KHIỂN TỰ ĐỘNG

CHƯƠNG 4

35

assume(de3,'real');
assume(dde2,'real'); assume(dde3,'real'); assume(m1,'real'); assume(m2,'real'); assume(m3,'real');
assume(I2,'real'); assume(I3,'real'); assume(g,'real');
%% Động học thuận Robot SCARA
[T01,R01,R10,P01] = FKRobot(0,0,d1,0); [T12,R12,R21,P12] = FKRobot(0,L1,0,e2); [T23,R23,R32,P23] = FKRobot(0,L2,0,e3); %% Vị trí của trọng tâm ở mỗi khâu: P1c = [L1/2 0 0]';
P2c = [L2/2 0 0]';
P3c = [L3/2 0 0]';
%% Vận tốc dài và vận tốc góc tại khâu thứ 0: w0 = [0 0 0]';
v0 = [0 0 0]';
%% Tại khâu 1:
% Vị trí trọng tâm khâu 1 so với hệ tọa độ gốc
TP01c = (T01*[P1c;1]);
P01c = TP01c(1:3);
% Vận tốc góc trong hệ trục tọa độ 1. Do khớp 1 chuyển động tịnh tiến nên
% không có vận tốc góc
w1 = [0; 0; 0];
% Vận tốc dài trong hệ trục tọa độ 1
v1 = R10*(v0+[0 -w0(3) w0(2);w0(3) 0 -w0(1);-w0(2) w0(1) 0]*P01); % Vận tốc dài tại trọng tâm của hệ trục tọa độ 1 so với hệ trục tọa độ 0
v01c = R01*(v1+[0 -w1(3) w1(2);w1(3) 0 -w1(1);-w1(2) w1(1) 0]*P1c);
%% Tại khâu 2:
% Vị trí trọng tâm khâu 2 so với hệ tọa độ gốc
TP02c = (T01*T12*[P2c;1]);
P02c = TP02c(1:3);
% Vận tốc góc trong hệ trục tọa độ 2
w2 = R21*w1+de2*[0 0 1]';
% Vận tốc dài trong hệ trục tọa độ 2
v2 = R21*(v1+[0 -w1(3) w1(2);w1(3) 0 -w1(1);-w1(2) w1(1) 0]*P12); % Vận tốc dài tại trọng tâm của hệ trục tọa độ 2 so với hệ trục tọa độ 0
v02c = R01*R12*(v2+[0 -w2(3) w2(2);w2(3) 0 -w2(1);-w2(2) w2(1) 0]*P2c);
%% Tại khâu 3:
% Vị trí trọng tâm khâu 3 so với hệ tọa độ gốc
TP03c = (T01*T12*T23*[P3c;1]);
P03c = TP03c(1:3);
% Vận tốc góc trong hệ trục tọa độ 3
w3 = R32*w2+de3*[0 0 1]';
% Vận tốc dài trong hệ trục tọa độ 3

BỘ MÔN ĐIỀU KHIỂN TỰ ĐỘNG

CHƯƠNG 4

36

v3 = R32*(v2+[0 -w2(3) w2(2);w2(3) 0 -w2(1);-w2(2) w2(1) 0]*P23); % Vận tốc dài tại trọng tâm của hệ trục tọa độ 3 so với hệ trục tọa độ 0
v03c = R01*R12*R23*(v3+[0 -w3(3) w3(2);w3(3) 0 -w3(1);-w3(2) w3(1) 0]*P3c);
%% Tổng năng lượng động năng:
% Vì khớp 1 chuyển động tịnh tiến nên moment quán tính bằng 0, và cũng không có
% năng lượng được sinh ra từ chuyển động quay
K = 1/2*(m1*v01c'*v01c) + 1/2*(m2*v02c'*v02c+I2*w2'*w2) + 1/2*(m3*v03c'*v03c+I3*w3'*w3);
%% Tổng năng lượng thế năng:
U = -m1*[0 0 g]*P01c - m2*[0 0 g]*P02c - m3*[0 0 g]*P03c; %% Phương trình Lagrange:
L = simplify(K-U);
dLde2 = diff(L,e2);
dLde3 = diff(L,e3);
dLdde2 = diff(L,de2);
dLdde3 = diff(L,de3);
%% Torque
t2 =
simplify(diff(dLdde2,e2)*de2+diff(dLdde2,e3)*de3+diff(dLdde2,de2)* dde2+diff(dLdde2,de3)*dde3 - dLde2);
t3 =
simplify(diff(dLdde3,e2)*de2+diff(dLdde3,e3)*de3+diff(dLdde3,de2)* dde2+diff(dLdde3,de3)*dde3 - dLde3);
%% Các ma trận động lực học của Robot SCARA
% Ma trận quán tính M:
M =
simplify([diff(t2,dde2),diff(t2,dde3);diff(t3,dde2),diff(t3,dde3)] );
% Ma trận trọng trường G:
G = simplify([diff(U,e2);...
diff(U,e3)]);
% Ma trận Coriolis C:
dM =
simplify([diff(M(1,1),e2)*de2+diff(M(1,1),e3)*de3,diff(M(1,2),e2)* de2+diff(M(1,2),e3)*de3;...

diff(M(2,1),e2)*de2+diff(M(2,1),e3)*de3,diff(M(2,2),e2)*de2+diff(M (2,2),e3)*de3]);
dMde2 = Comp_dMdei(M,e2);
dMde3 = Comp_dMdei(M,e3);
de = [de2,de3]';
dde = [dde2,dde3]';
C = simplify(dM-1/2*([de'*dMde2;de'*dMde3]));
%% Kiểm tra tính đúng đắn của phương trình động lực học Robot t = [t2,t3]';

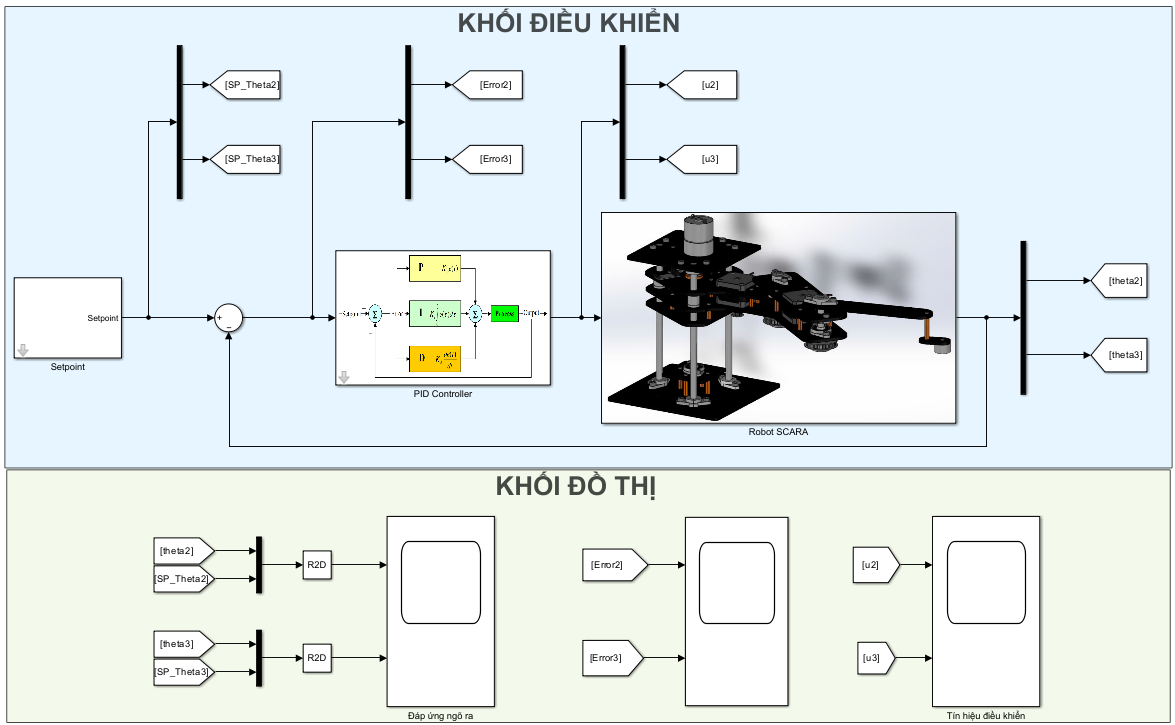
[picture p24: figure]

BỘ MÔN ĐIỀU KHIỂN TỰ ĐỘNG

CHƯƠNG 4

37

simplify(t-M*dde-C*de-G);
inv(M)*(t-C*de-G)

Bảng 4.6: Chương trình MATLAB tính động lực học Robot SCARA

### 4.8 Thiết kế bộ điều khiển PID cho Robot:

Hình 4.5: Cấu trúc chương trình bộ điều khiển PID cho Robot SCARA trên

MATLAB Simulink

Gồm có 2 khối lớn là khối điều khiển và khối đồ thị.

- Khối điều khiển: gồm 2 bộ điều khiển PID điều khiển cho 2 khâu của Robot (ta

không xét khớp tịnh tiến), các giá trị đặt, và khối Robot để mô tả động lực học

robot mà ta đã tính ở trên.
- Khối đồ thị: để xem đồ thị đáp ứng ngõ ra vị trí, sai số hệ thống và tín hiệu điều

khiển.

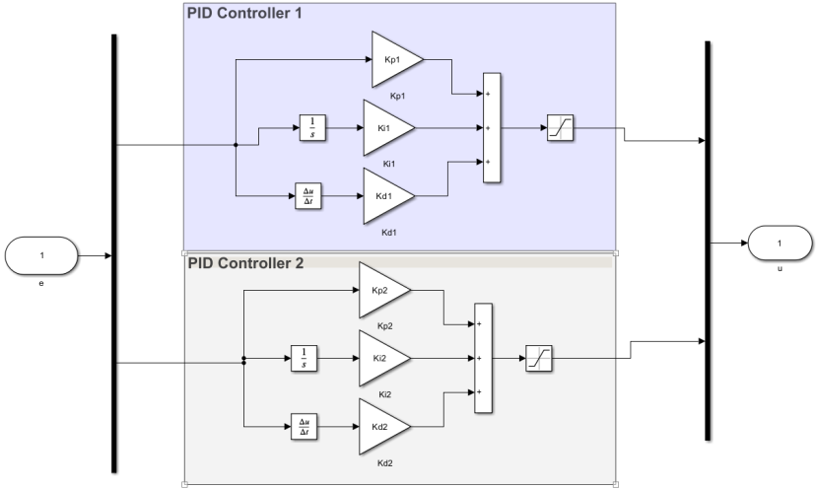
[picture p25: figure]
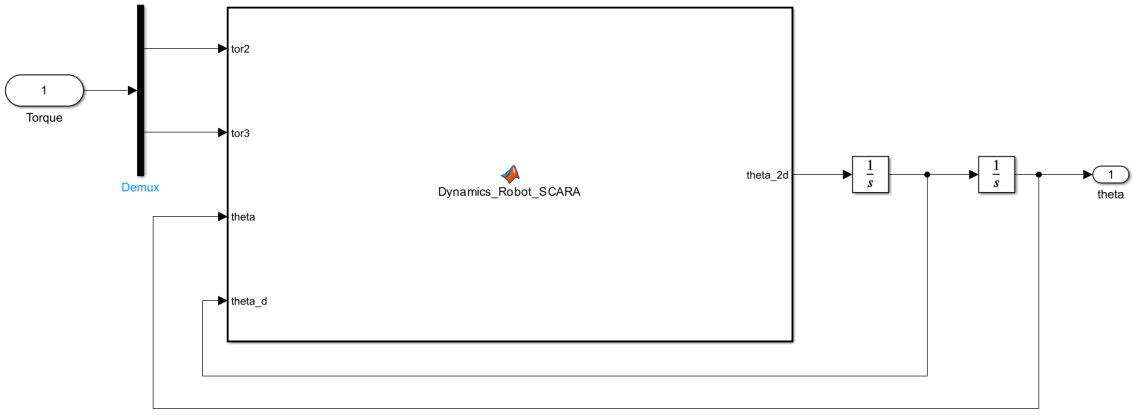
[picture p26: figure]

BỘ MÔN ĐIỀU KHIỂN TỰ ĐỘNG

CHƯƠNG 4

38

Hình 4.6: Cấu trúc 2 bộ điều khiển PID cho 2 khâu Robot

Hình 4.7: Khối hàm MALAB Function mô tả động lực học Robot SCARA

function theta_2d = Dynamics_Robot_SCARA(tor2, tor3, theta, theta_d)
%% Khai báo biến
theta2 = theta(1); theta3 = theta(2);
theta2_d = theta_d(1); theta3_d = theta_d(2); %theta_d = [theta2_d,theta3_d]';
%% Thông số Robot_SCARA
m1 = 2; m2 = 1.5; m3 = 1;
L1 = 0.12025; L2 = 0.16473; L3 = 0.15086; g = -9.81; I2 = 0.01; I3 = 0.01;
% Hệ số ma sát trượt b
b2 = 0.1; b3 = 0.1;
b = [ b2 0;...
0 b3];
% Hệ số ma sát nhớt c
c2 = 1e-4; c3 = 1e-4;
c = [c2 0;...
0 c3];
% Thành phần ma sát:

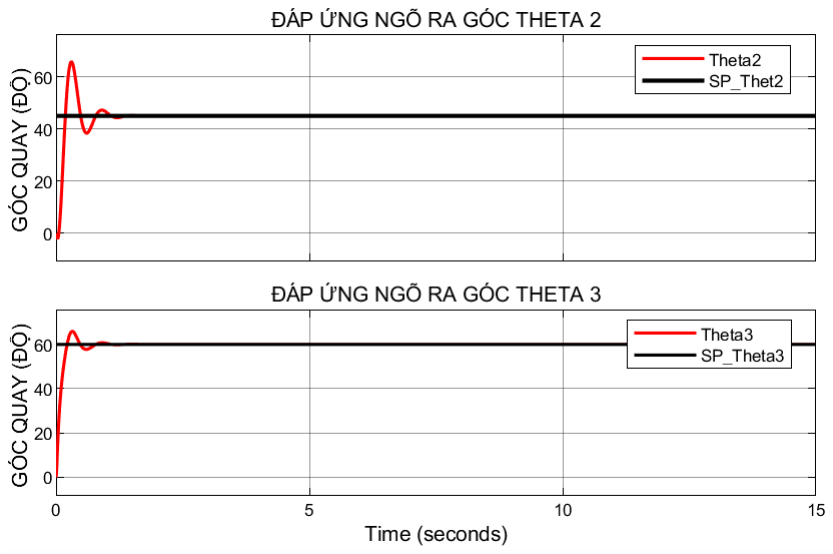
[picture p27: figure]

BỘ MÔN ĐIỀU KHIỂN TỰ ĐỘNG

CHƯƠNG 4

39

tf = c*sign(theta_d) + b*theta_d;
%% Các ma trận động lực học của Robot SCARA
% Ma trận quán tính M
M11 = I2 + I3 + (L2^2*m2)/4 + L2^2*m3 + (L3^2*m3)/4 + L2*L3*m3*cos(theta3);
M12 = (m3*L3^2)/4 + (L2*m3*cos(theta3)*L3)/2 + I3; M21 = (m3*L3^2)/4 + (L2*m3*cos(theta3)*L3)/2 + I3; M22 = (m3*L3^2)/4 + I3;
M = [M11 , M12 ;...
M21 , M22];
% Ma trận Coriolis C
C11 = -L2*L3*theta3_d*m3*sin(theta3);
C12 = -(L2*L3*theta3_d*m3*sin(theta3))/2;
C21 = (L2*L3*m3*sin(theta3)*(2*theta2_d - theta3_d))/4; C22 = (L2*L3*theta2_d*m3*sin(theta3))/4;
C = [C11 , C12 ;...
C21 , C22 ];
% Ma trận trọng trường G
G11 = 0;
G21 = 0;
G = [G11 ; G21];
% Ma trận momen xoắn tor của Robot Scara tor = [tor2 ; tor3];
%% Phương trình vi phân của Robot Scara
theta_2d = inv(M)*(tor-C*theta_d-G-tf);
end
Bảng 4.7: Code của khối hàm MATLAB Function mô tả động lực học Robot Scara

Hình 4.8: Đáp ứng ngõ ra vị trí góc (độ) của 2 khâu robot tại setpoint 45 độ và 60

độ

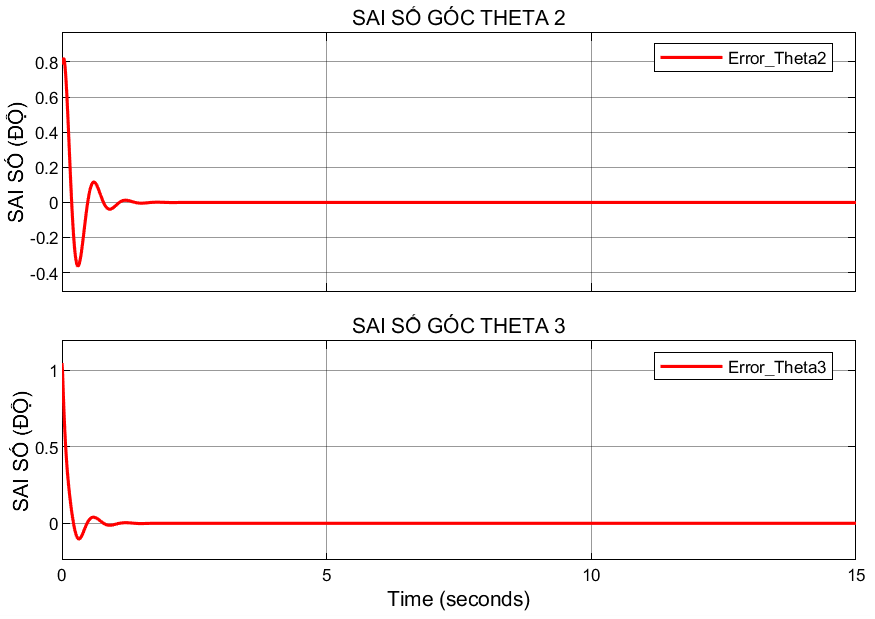
[picture p28: figure]
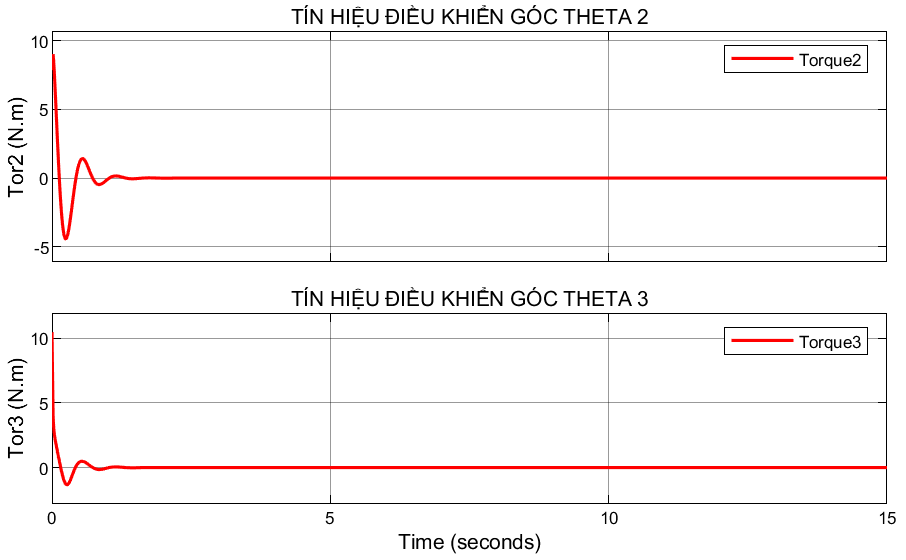
[picture p29: figure]

BỘ MÔN ĐIỀU KHIỂN TỰ ĐỘNG

CHƯƠNG 4

40

Hình 4.9: Đáp ứng sai số hệ thống của các khâu Robot

Hình 4.10: Đáp ứng tín hiệu điều khiển cho các khâu của Robot

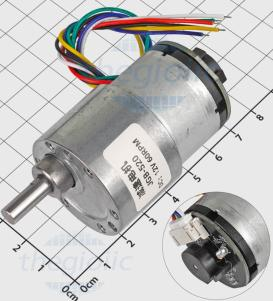
[picture p30: figure]

BỘ MÔN ĐIỀU KHIỂN TỰ ĐỘNG

CHƯƠNG 5

41

## CHƯƠNG 5: THI CÔNG MÔ HÌNH THỰC TẾ

### 5.1 Lựa chọn động cơ:

Hình 5.1: Động cơ JGB37-520 Encoder, 60RPM Với động cơ JGB37-520 có giá trị lực kéo Moment tối đa có thể đạt được là

31kg.cm. Do đó có thể dùng làm động cơ cho khớp tịnh tiến của Robot Scara mà

không sợ bị quá tải do moment không đủ, sau đây là một vài thông số cơ bản về động

cơ JGB37-520.
❖ Thông số kĩ thuật:

✓ Tốc độ quay: 60 rpm

✓ Điện áp: 12VDC
✓ Loại: Có chổi than

✓ Đường kính trục: 6mm
✓ Chiều dài động cơ: 47mm

✓ Đường kính động cơ: 37mm ✓ Tỉ số truyền: 1:168

✓ Xung / Vòng:11 xung

### 5.2 Lựa chọn vi điều khiển:

Có rất nhiều loại vi điều khiển hiện nay nhưng chúng ta nên chọn loại có giá

thành hợp lý, dễ sử dụng và lập trình. Với những tiêu chí đó thì em sẽ ưu tiên chọn

Arduino. Dưới đây là bảng so sánh các thông số cơ bản của các vi điều khiển Arduino

phổ biến hiện nay:

Thông số | Arduino Nano | Arduino Uno | Arduino Mega

Hình ảnh

BỘ MÔN ĐIỀU KHIỂN TỰ ĐỘNG

CHƯƠNG 5

42

Kích thước | Kích thước nhỏ gọn (18 x 45 mm) và có hình dạng dạng hình chữ nhật. | Arduino Uno: Kích thước trung bình (68.6 x 53.4 mm) và có hình dạng hình chữ nhật. | Arduino Mega: Kích thước lớn (101.6 x 53.3 mm) và có hình dạng hình chữ nhật. Có nhiều chân I/O
Bộ xử lý | ATmega328P tốc độ 16 MHz | ATmega328P tốc độ 16 MHz | ATmega2560 tốc độ 16 MHz
Chân I/O | 14 chân digital và 8 chân analog | 14 chân digital và 6 chân analog | 54 chân digital và 16 chân analog
Bộ nhớ và EEPROM | 32KB bộ nhớ flash và 1KB EEPROM | 32KB bộ nhớ flash và 1KB EEPROM | 256KB bộ nhớ flash và 4KB EEPROM

Bảng 5.1: So sánh các loại Arduino Bởi vì chỉ cần 2 chân ngắt ngoài để đọc tín hiệu encoder nên ở đây chỉ cần

Arduino Uno R3 là đã đáp ứng được cho đề tài này.

- Vi điều khiển chính: Atmega328
- Nguồn nuôi mạch: 5V
- Số chân Digital: 14 (6 chân PWM)
- Số chân Analog: 6 (độ phân giải 10 bit)
- Giao tiếp UART: 1 bộ UART
- Giao tiếp SPI: 1 bộ
- Giao tiếp I2C: 1 bộ
- Ngắt ngoài: 2 chân
- Dòng tiêu thụ: 30mA
- EEPROM: 1 KB
- Bootloader: Arduino Uno
- Xung clock: 16 MHz
- Kích thước: 75x55x15mm

### 5.3 Lựa chọn dây đai truyền động:

### 5.3.1 Công thức tính độ dài dây đai:

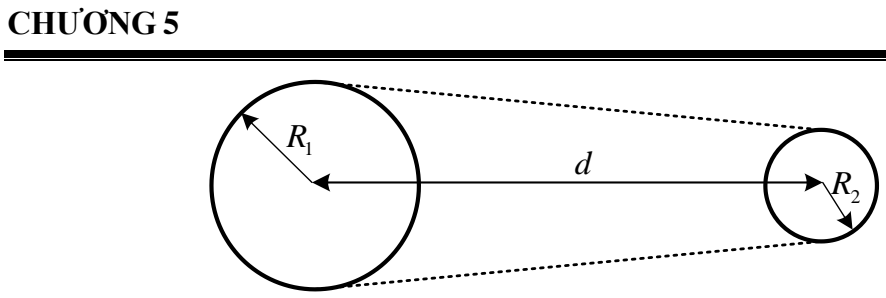
[picture p31: figure]
CHƯƠNG 5

BỘ MÔN ĐIỀU KHIỂN TỰ ĐỘNG

43

Hình 5.2: Hình minh họa thông số độ dài dây đai

Dựa vào hình minh họa bên trên ta có công thức tính xấp xỉ độ dài dây đai là:

l = 2d + (R1 + R2)π

Trong đó:
✓ l: Chiều dài dây đai.

✓ d: Khoảng cách giữa 2 trục truyền động

✓ R1, R2: Bán kính của 2 trục truyền động

### 5.3.2 Tính toán và lựa chọn dây đai phù hợp cho mô hình:

Ở các link ta đều sử dụng chung các trục truyền động với bán kính R1 =

0.59(cm) và R2 = 1.885(cm)

❖ Tính toán độ dài dây đai link 2:

Khoảng cách giữa 2 trục quay ở link 2 là 6.11(cm), áp dụng công thức bên trên

ta tính được độ dài dây đai là:
l = 2 ∗ 6.11 + (0.59 + 1.885)π ≈ 20(cm)

❖ Tính toán độ dài dây đai link 3:

Khoảng cách giữa 2 trục quay ở link 3 là 6.11(cm), áp dụng công thức bên trên

ta tính được độ dài dây đai là:
l = 2 ∗ 6.11 + (0.59 + 1.885)π ≈ 20(cm)
- Từ thông số tính toán được, ta sẽ lựa chọn dây đai loại 20cm cho link 2, 3.

### 5.4 Lựa chọn thiết bị phần cứng:

### 5.4.1 Lựa chọn thiết bị phần cơ:

STT | Tên linh kiện | Số lượng | Hình ảnh | Đơn giá
1 | Đai ốc và trục vít me 8mm dài 250mm | 2 đai ốc và 1 trục vít me | | 43.000

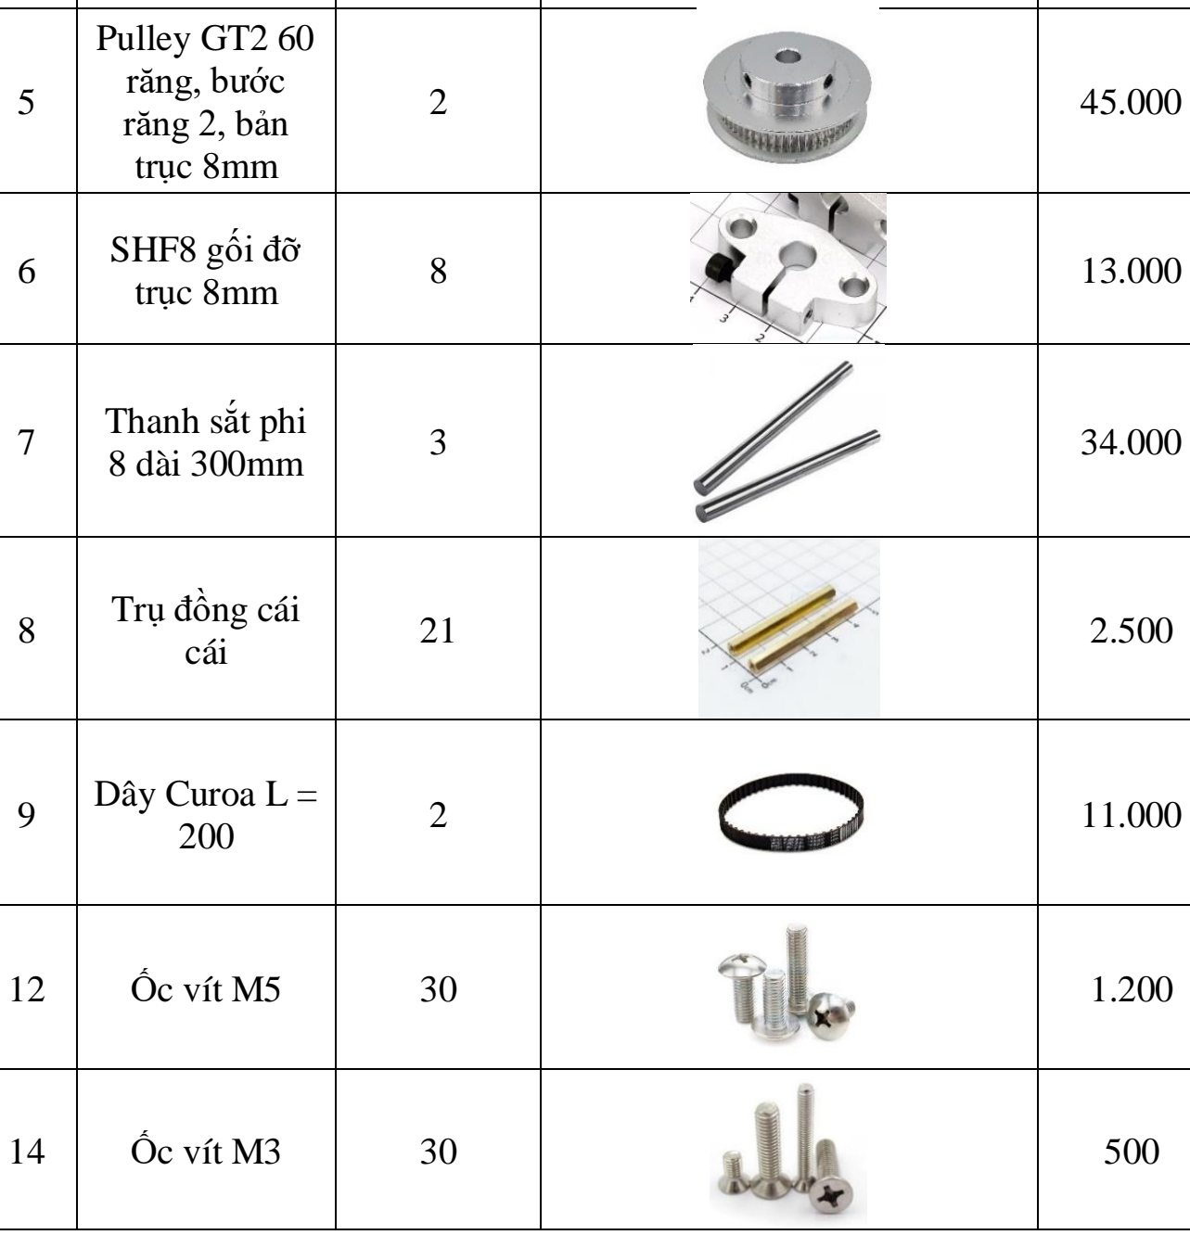
[picture p32: figure]
SHF8 gối đỡ trục 8mm; Thanh sắt phi 8 dài 300mm; Trụ đồng cái cái; Dây Curoa L = 200; Ốc vít M5; Ốc vít M3

BỘ MÔN ĐIỀU KHIỂN TỰ ĐỘNG

CHƯƠNG 5

44

2 | Gối Đỡ Vòng Bi 8mm | 5 | 16.000
3 | Khớp nối vít me 8mm | 1 | 17.000
4 | Bánh Răng 2GT 16 Răng, Bước răng 2mm, trục 6.35mm | 2 | 9.000
5 | Pulley GT2 60 răng, bước răng 2, bản trục 8mm | 2 | 45.000

Bảng 5.2: Bảng lựa chọn thiết bị phần cơ

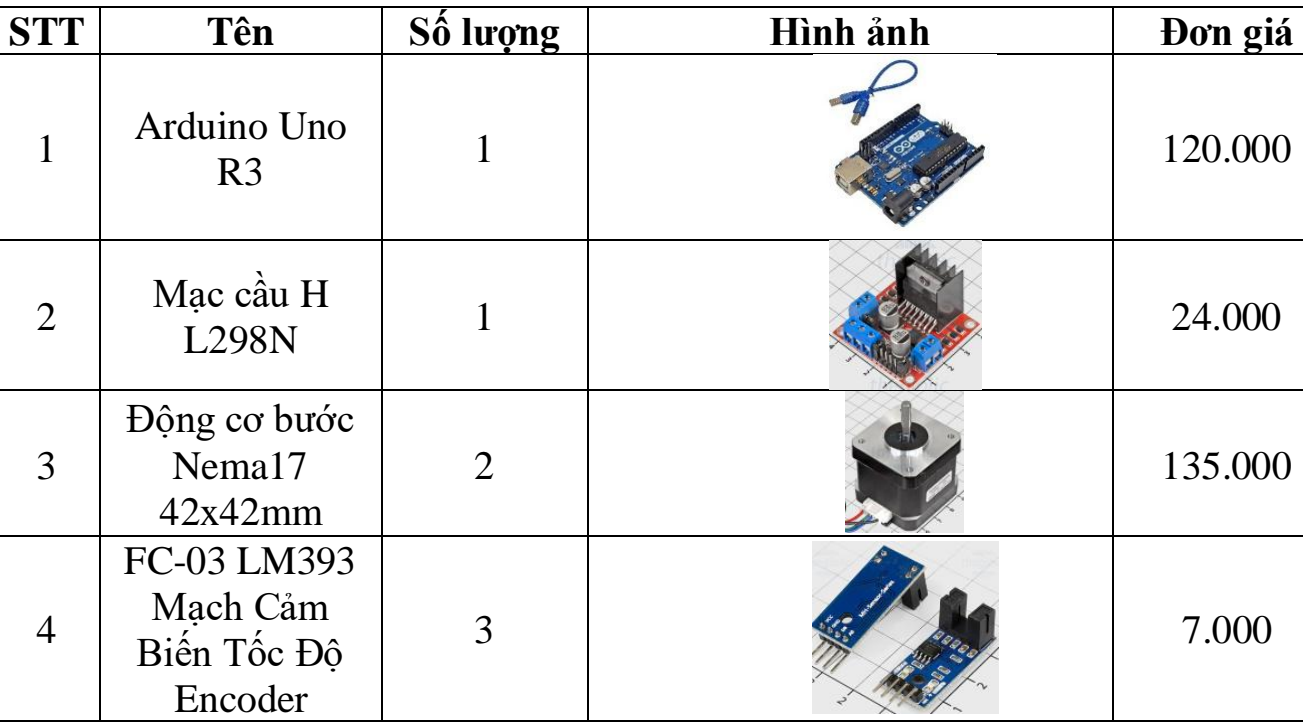
[picture p33: figure]
STT; Tên; Số lượng; Hình ảnh; Đơn giá; Arduino Uno R3; Mạc cầu H L298N; Động cơ bước Nema17 42x42mm

BỘ MÔN ĐIỀU KHIỂN TỰ ĐỘNG

CHƯƠNG 5

45

### 5.4.2 Lựa chọn thiết bị phần điện:

4 | FC-03 LM393 Mạch Cảm Biến Tốc Độ Encoder | 3 | | 7.000
5 | Nguồn tổ ong 12V 10A 120W | 1 | | 126.000
6 | ELE-P20/15 12V Nam Châm Điện 3Kg | 1 | | 94.000
7 | Động cơ JGB37-520, 60RPM | 1 | | 194.000
8 | Arduino CNC Shield V3 | 1 | | 36.000
9 | Driver 8825 điều khiển động cơ bước | 2 | | 27.000

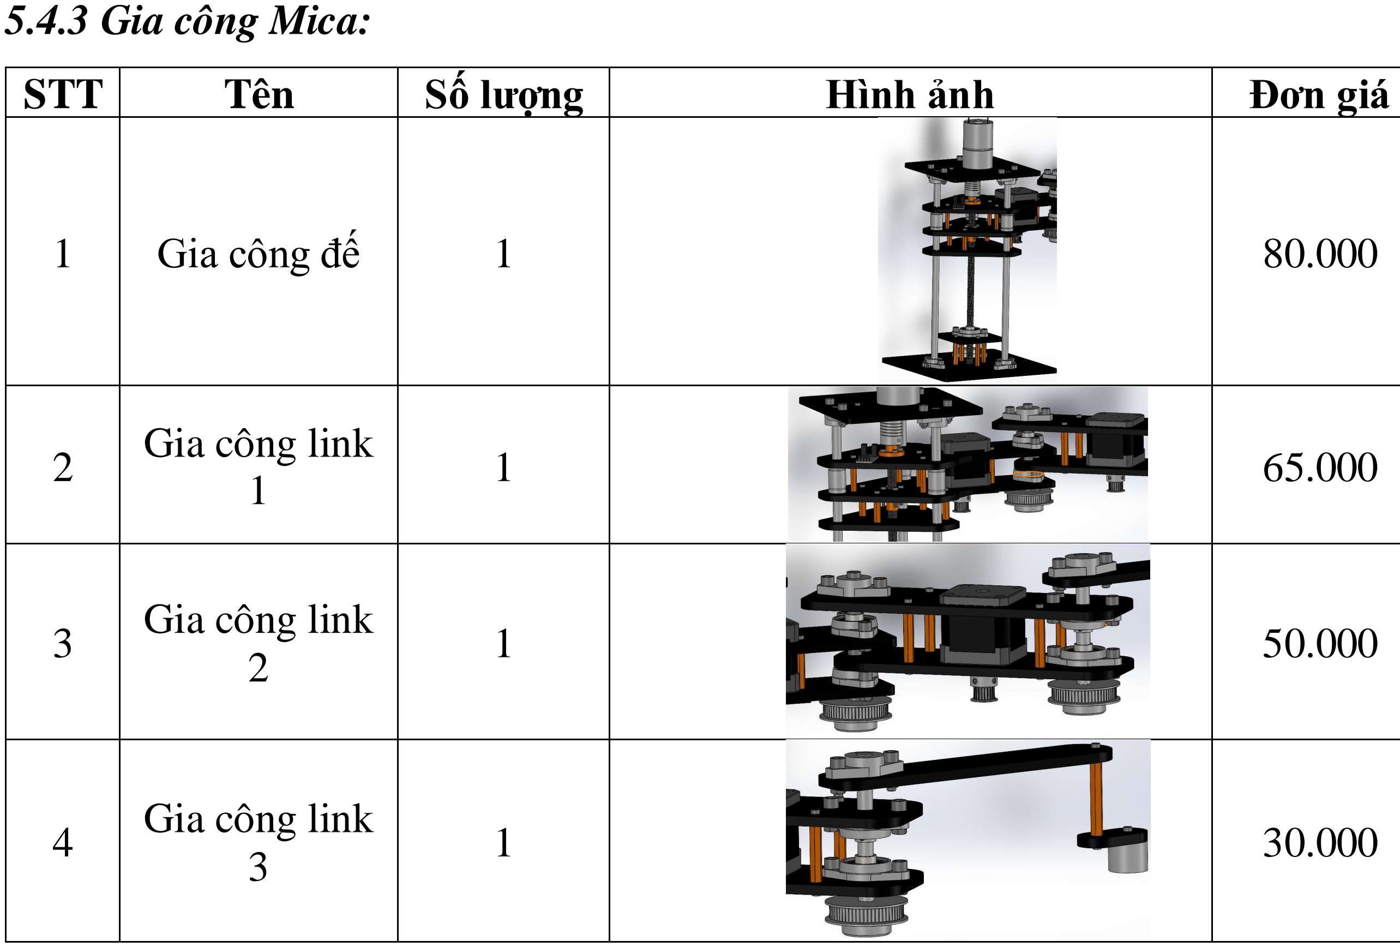
[picture p34: figure]
5.4.3 Gia công Mica:; STT; Tên; Số lượng; Hình ảnh; Đơn giá; Gia công đế; Gia công link 1; Gia công link 2; Gia công link 3
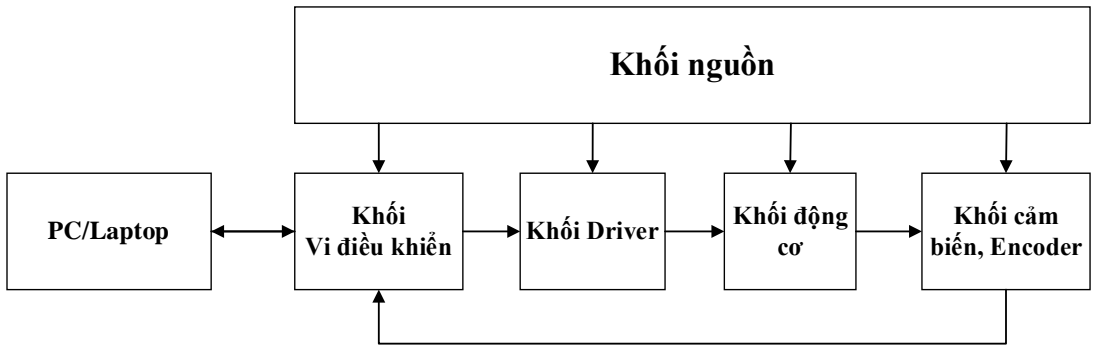
[picture p35: figure]
PC/Laptop; Khối nguồn; Khối; Vi điều khiển; Khối Driver; Khối động; Khối cảm biến, Encoder

BỘ MÔN ĐIỀU KHIỂN TỰ ĐỘNG

CHƯƠNG 5

46

10

Module 1
Relay 5V kích
mức cao/thấp
1 | 13.000

Bảng 5.3: Lựa chọn thiết bị phần điện

Bảng 5.4: Bảng gia công Mica

### 5.5 Sơ đồ khối tổng quan:

Hình 5.3: Sơ đồ khối tổng quan robot

Hệ thống gồm có 6 khối chính:

✓ Khối nguồn: Cung cấp nguồn điện DC đến các linh kiện cần sử dụng.

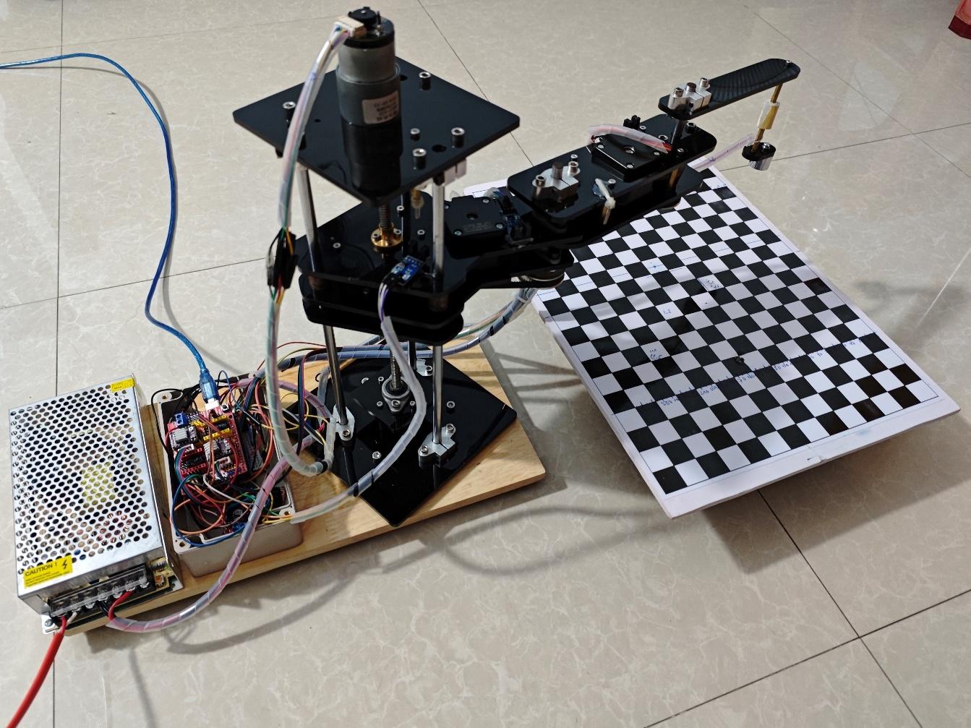
[picture p36: figure]

BỘ MÔN ĐIỀU KHIỂN TỰ ĐỘNG

CHƯƠNG 5

47

✓ Khối PC/Laptop: Ra tín hiệu điều khiển cũng như nhận tín hiệu được gửi về từ

vi điều khiển.

✓ Khối vi điều khiển: Chạy các giải thuật điều khiển Robot, xử lý tín hiệu cảm

biến…

✓ Khối Driver: Điều khiển động cơ.

✓ Khối cảm biến: Đọc tín hiệu từ các cảm biến để gửi về vi điều khiển xử lý.

### 5.6 Mô hình thực tế sau khi thi công:

Hình 5.4: Mô hình Robot Scara nhìn từ phải qua

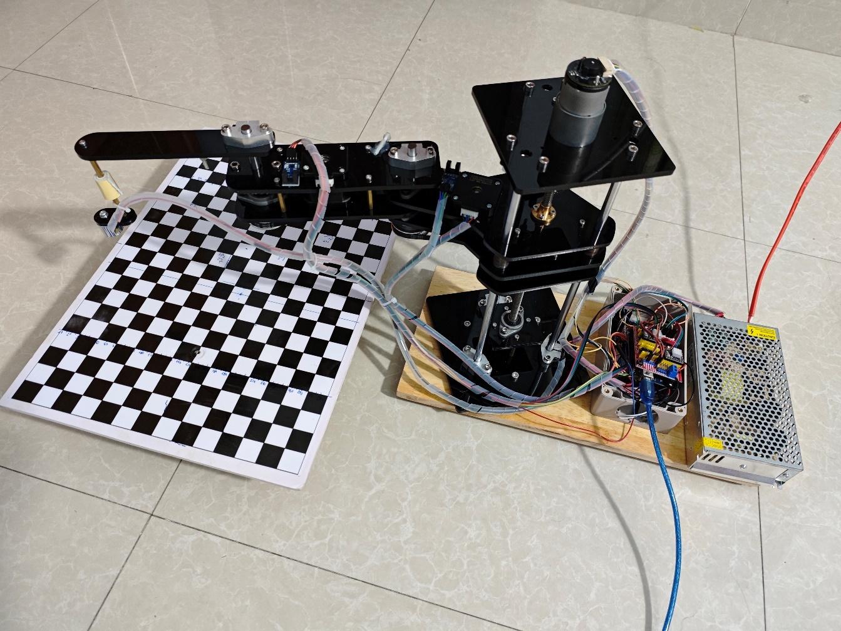
[picture p37: figure]

BỘ MÔN ĐIỀU KHIỂN TỰ ĐỘNG

CHƯƠNG 5

48

Hình 5.5: Mô hình Robot Scara nhìn từ trái qua

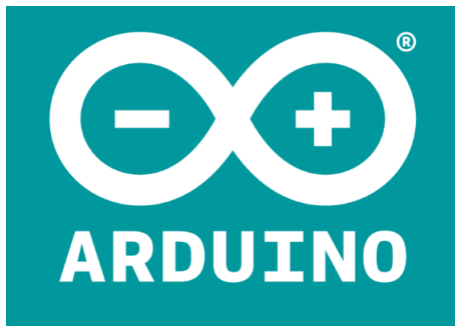
[picture p38: figure]

BỘ MÔN ĐIỀU KHIỂN TỰ ĐỘNG

CHƯƠNG 6

49

## CHƯƠNG 6: THIẾT KẾ CHƯƠNG TRÌNH ĐIỀU

## KHIỂN

### 6.1 Giới thiệu về phần mềm Arduino IDE:

Arduino IDE là một phần mềm với một mã nguồn mở, được sử dụng chủ yếu

để viết và biên dịch mã vào module Arduino. Nó bao gồm phần cứng và phần mềm.

Phần cứng chứa đến 300,000 board mạch được thiết kế sẵn với các cảm biến, linh

kiện. Phần mềm giúp bạn có thể sử dụng các cảm biến, linh kiện ấy của Arduino một

cách linh hoạt phù hợp với mục đích sử dụng.

Hình 6.1: Phần mềm Arduino IDE

Khi người dùng viết mã và biên dịch, IDE sẽ tạo file Hex cho mã. File Hex là các

file thập phân Hexa được Arduino hiểu và gửi đến bo mạch bằng cáp USB. Mỗi bo

Arduino đều được tích hợp một bộ vi điều khiển, bộ vi điều khiển sẽ nhận file Hex

và chạy theo mã được viết.

Arduino IDE sử dụng ngôn ngữ lập trình C/C++ rất phổ biến trong giới lập trình.

Bất kỳ đoạn code nào của C/C++ thì Arduino IDE đều có thể nhận dạng, giúp các lập

trình viên thuận tiện trong việc thiết kế chương trình lập cho các bo mạch Arduino.

### 6.2 Tổng quan về hoạt động của Robot:

Robot được điều khiển bằng Giao diện GUI. Ban đầu, ta cần phải Set Home cho

robot để robot có thể xác định được góc toạ độ.

Robot hoạt động dựa theo chuỗi được gửi xuống từ GUI. Khi nhận được tín hiệu

chuỗi, Robot sẽ tiến hành tách chuỗi và xác định Mode hoạt động.

Từ việc đọc Encoder, cấp xung vô driver điều khiển động cơ bước ta tính toán và

biết được vị trí Robot.

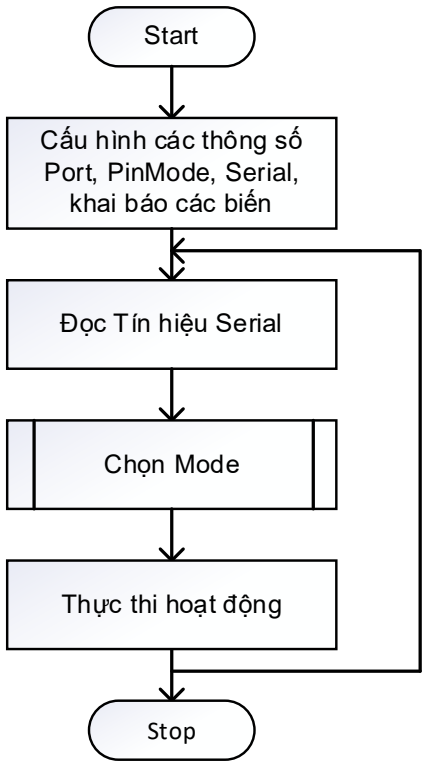
[picture p39: figure]
Start; Cấu hình các thông số; Port, PinMode, Serial, khai báo các biến; Đọc Tín hiệu Serial; Chọn Mode; Stop; Thực thi hoạt động

BỘ MÔN ĐIỀU KHIỂN TỰ ĐỘNG

CHƯƠNG 6

50

### 6.3 Lưu đồ giải thuật tổng quan điều khiển Robot:

Robot hoạt động theo nguyên tắc nhận tín hiệu điều khiển từ Serial. Ứng với mỗi

tín hiệu nhận được sẽ thực thi một công việc cụ thể. Cụ thể các công việc Robot thực

thi sẽ được trình bày lần lượt ở các phần tiếp theo.

Giải thuật điều khiển Robot được trình bày như hình bên dưới:

Hình 6.2: Lưu đồ giải thuật tổng quan điều khiển robot

### 6.4 Các Mode hoạt động của robot:

Đầu tiên để robot có thể hoạt động ta cần chia các trạng thái hoạt động cho

Robot, trạng thái sẽ được xác định bằng chuỗi chữ mà ta gửi.

Ứng với mỗi trường hợp, Robot sẽ thực thi các hành động khác nhau. Cụ thể

như sau:

STT | Chuỗi chữ | Hành động
1 | rol1 x | Tịnh tiến link 1 đến vị trí x mm. VD: rol1 150 là tịnh tiến link 1 đến vị trí 150mm
2 | rol2 y | Điều khiển link 2 góc y độ. VD: rol2 -30 là điều khiển link 2 góc -30 độ
3 | rol3 z | Điều khiển link 3 góc z độ. VD: rol3 60 là điều khiển link 3 góc 60 độ

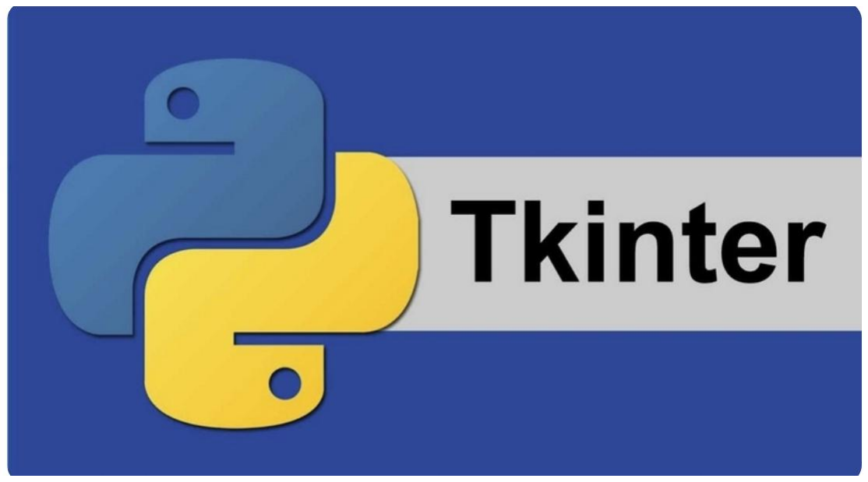
[picture p40: figure]

BỘ MÔN ĐIỀU KHIỂN TỰ ĐỘNG

CHƯƠNG 6

51

4 | shrobot | Set Home robot
5 | shl1 | Set Home link 1 robot
6 | shl2 | Set Home link 2 robot
7 | shl3 | Set Home link 3 robot
8 | magon | Bật nam châm điện
9 | magoff | Tắt nam châm điện
10 | stop | Dừng hoạt động của cả 3 link robot
11 amxnypz | | Tịnh tiến link 1 đến vị trí m mm, quay link 2 góc n độ và quay link 3 góc p độ. VD: a200x45y-60z là tịnh tiến link 1 đến vị trí 200mm, link 2 góc 45 độ và link 3 góc -60 độ

Bảng 6.1: Các chuỗi chữ gửi đi để chọn Mode hoạt động cho robot

### 6.5 Thiết kế giao diện GUI sử dụng thư viện Tkinter:

### 6.5.1 Giới thiệu về thư viện tkinter:

Tkinter là một thư viện lập trình giao diện người dùng đồ họa (GUI - Graphical

User Interface) được tích hợp sẵn trong ngôn ngữ lập trình Python. Nó sẽ giúp

người dùng tương tác với chương trình thông qua các thành phần đồ họa như

nút bấm, ô nhập liệu, nhãn văn bản...

Hình 6.3: Logo Tkinter
Dựa trên thư viện Tk (viết bằng C), Tkinter mang đến một cách tiếp cận dễ dàng

cho cả người mới bắt đầu và lập trình viên có kinh nghiệm, cho phép họ xây dựng các

ứng dụng với giao diện người dùng từ đơn giản đến phức tạp mà không cần phải nắm

vững các khái niệm đồ họa phức tạp. Với cú pháp dễ hiểu và khả năng tích hợp liền

mạch với Python, Tkinter là một lựa chọn lý tưởng để nhanh chóng tạo ra các prototype

và ứng dụng GUI hoàn chỉnh.

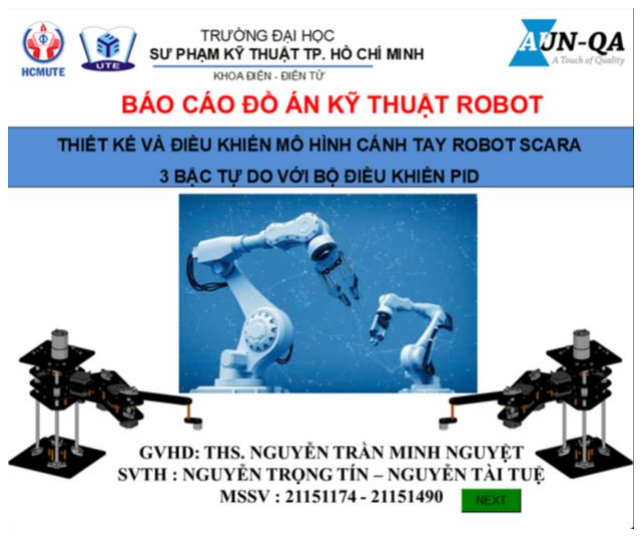
[picture p41: figure]
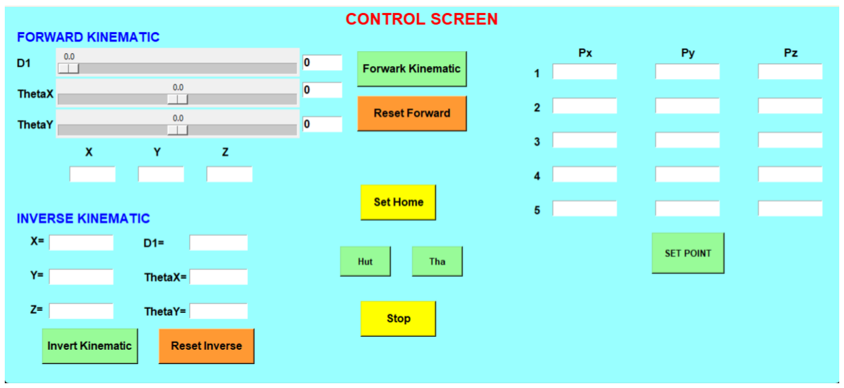
[picture p42: figure]

BỘ MÔN ĐIỀU KHIỂN TỰ ĐỘNG

CHƯƠNG 6

52

### 6.5.2 Giao diện GUI điều khiển robot dựa trên thư viện Tkinter của Python:

Phần mềm: Visual Studio Code.

Giao diện GUI mà em thiết kế bao gồm 2 trang là: giao diện giới thiệu và giao diện

điều khiển.

Hình 6.4: Giao diện giới thiệu Giao diện giới thiệu: Gồm Logo của trường; khoa; tên môn học; tên đề tài; hình

minh họa robot; tên giảng viên hướng dẫn và sinh viên thực hiện. Ngoài ra còn có nút

NEXT để chuyển trang sang giao diện điều khiển.

Hình 6.5: Giao diện điều khiển

Giao diện điều khiển: Nhằm hướng tới sự đơn giản và dễ dàng điều khiển đối

với người vận hành cũng như người dùng, em đã thiết kế giao diện điều khiển rất đơn

BỘ MÔN ĐIỀU KHIỂN TỰ ĐỘNG

CHƯƠNG 6

53

giản nhưng vẫn đầy đủ các thông tin để điều khiển và vận hành một Robot. Giao diện

điều khiển được chia thành 4 phần chính:

❖ Phần thứ 1: “FORWARD KINEMATIC” Thông tin về góc khớp và vị trí

chúng ta nhập vào để gửi cho robot tịnh tiến và xoay. Đồng thời có những vị trí được

lưu trước và phần hút của nam châm. Ngoài ra, chúng ta có thể xem trạng thái hiện

tại của nam châm đang bật hay tắt.

❖ Phần thứ 2: “INVERSE KINEMATIC” là phần lấy thông số vị trí từ động

học thuận qua động học nghịch để tính toán lại góc khớp.

❖ Phần thứ 3: “LOCATION ROBOT” đây là listview cho phép chúng ta

nhập vị trí của robot và trạng thái tắt bật của nam châm để robot điều khiển đến vị trí

đã nhập đó. Đồng thời có thể chạy tự động theo thứ tự từ trên xuống dưới mà chúng

ta không cần điều khiển.

❖ Phần thứ 4: “MANUAL FUNCTION” đây là các phần chức năng có thể

cho người dùng thao tác bằng tay với các chế độ thủ công.

BỘ MÔN ĐIỀU KHIỂN TỰ ĐỘNG

CHƯƠNG 7

54

## CHƯƠNG 7: KẾT LUẬN VÀ HƯỚNG PHÁT TRIỂN

### 7.1 Kết luận:

Qua đề tài “THIẾT KẾ VÀ ĐIỀU KHIỂN MÔ HÌNH CÁNH TAY ROBOT

SCARA 3 BẬC TỰ DO VỚI BỘ ĐIỀU KHIỂN PID”, em đã thực hiện được thành

công các nhiệm vụ như: tính động học, động lực học mô hình robot, quy hoạch quỹ đạo, vẽ không gian làm việc, xây dựng bộ điều khiển PID, thiết kế robot trên phần

mềm Solidwork, thi công mô hình thực tế và điều khiển robot bằng bộ điều khiển

PID, thiết kế giao diện GUI trên thư viện Tkinter để điều khiển robot gắp thả vật 5

điểm chạy tự động.

Về động học thuận, ta thấy robot đã đáp ứng được vị trí tịnh tiến và góc quay so

với giá trị mà ta nhập trên giao diện, sai số giữa giá trị tịnh tiến, góc quay và giá trị ta

nhập trên giao diện có sai số khá nhỏ. Về phần động học nghịch, ta thấy giao diện đã

tính đúng khi mà giá trị tịnh tiến, góc quay mà ta nhập với giá trị mà giao diện đã tính

toán đều trùng khớp với nhau. Ta cũng tính toán động lực học cho Robot Scara và

thiết kế được bộ điều khiển PID cho chất lượng tốt khi sai số xác lập và thời gian đáp

ứng đều nhỏ.

Thông qua bài báo cáo này, tuy vẫn có một số sai sót nhất định nhưng nhìn

chung thì hệ thống đã chạy ổn định, đáp ứng được cho mục đích và yêu cầu ta đã đặt

ra cho bài báo cáo này. Cần thiết phải thực hiện nhiều khảo sát, thí nghiệm, thực

nghiệm trên nhiều điều kiện khác nhau thì hệ thống thiết kế mới tốt hơn, chạy ổn định

hơn nữa và hướng đến được những đề tài cao hơn cho sau này.

### 7.2 Hướng phát triển:

Sau đây là một vài điểm em đề xuất để phát triển đề tài:

- Thiết kế lại khung robot cho cứng cáp hơn, chịu tải được tốt hơn.
- Dùng PID ghép tầng thay vì PID bình thường để giảm sai số và cải thiện hệ thống.
- Áp dụng bộ điều khiển nâng cao hơn cho robot như: bộ điều khiển trượt, bộ điều

khiển khiển LQR, bộ điều khiển hồi tiếp tuyến tính hóa…

- Áp dụng xử lý ảnh cho robot. Robot sẽ tự nhận diện vật thể (màu sắc, hình

dạng…) để tự động gắp vật chứ không cần nhập tọa độ cho vật thể cần gắp.

BỘ MÔN ĐIỀU KHIỂN TỰ ĐỘNG

TÀI LIỆU THAM KHẢO

55

## TÀI LIỆU THAM KHẢO

[1] John J.Craig - Introduction to Robotics Mechanics and Control 3rd edition-

Pearson Education, Inc. (2005)
[2] Nguyễn Thị Phương Hà, Huỳnh Thái Hoàng (2005), “Lý thuyết điều khiển

tự động”, Nhà xuất bản ĐHQG, Tp.HCM, Việt Nam

[3] Phạm Quang Huy, Lê Cảnh Trung, “Lập trình điều khiển với arduino”, Nhà

xuất bản khoa học và kỹ thuật.

BỘ MÔN ĐIỀU KHIỂN TỰ ĐỘNG

TÀI LIỆU THAM KHẢO

56
